michaelkrzyzaniak/squiggles-pipe-organ/README.md

# squiggles-pipe-organ
Pipe organ project for Dr Squiggles
