michaelkrzyzaniak/squiggles-pipe-organ/air_supply/design_files/Junction_Box.pdf

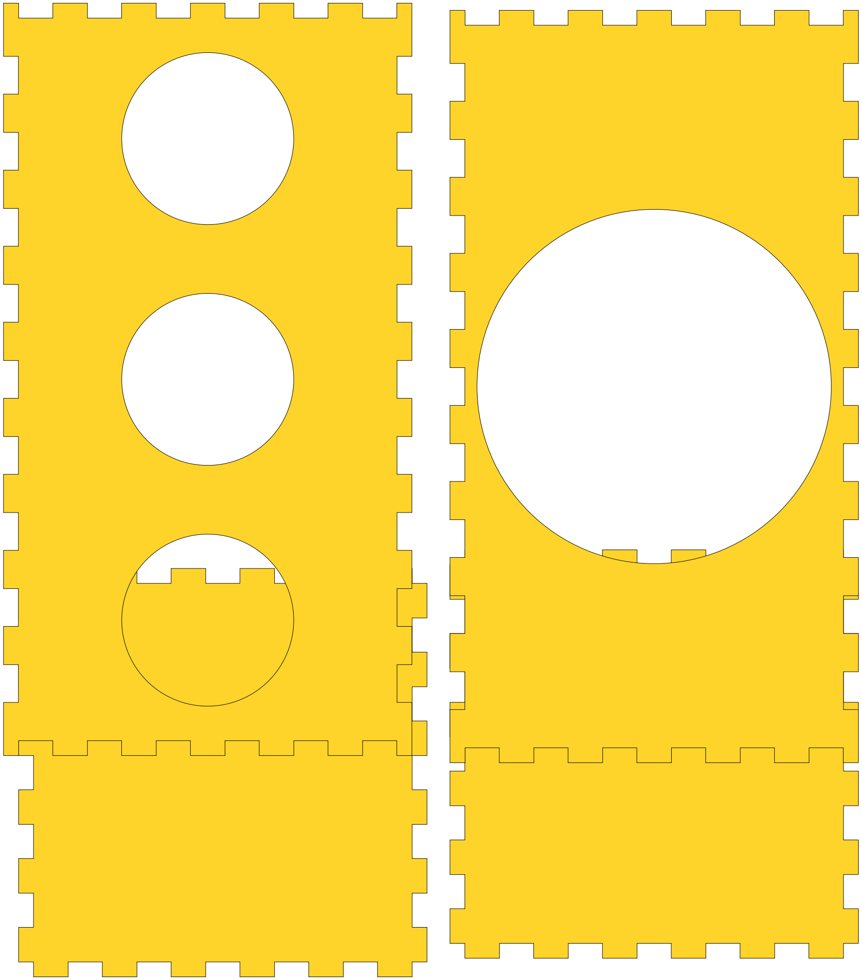
[picture p1: figure]
