michaelkrzyzaniak/squiggles-pipe-organ/air_supply/design_files/Wall.pdf

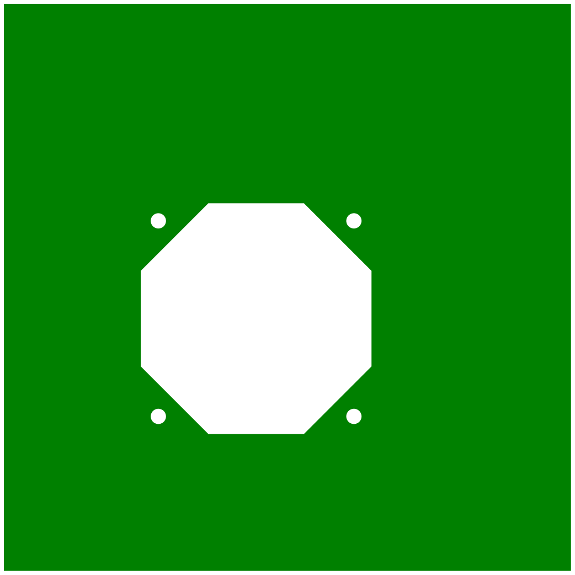
[picture p2: figure]
