michaelkrzyzaniak/squiggles-pipe-organ/wind_chest/design_files/Organ_Pipe_Box_Designs_2.pdf

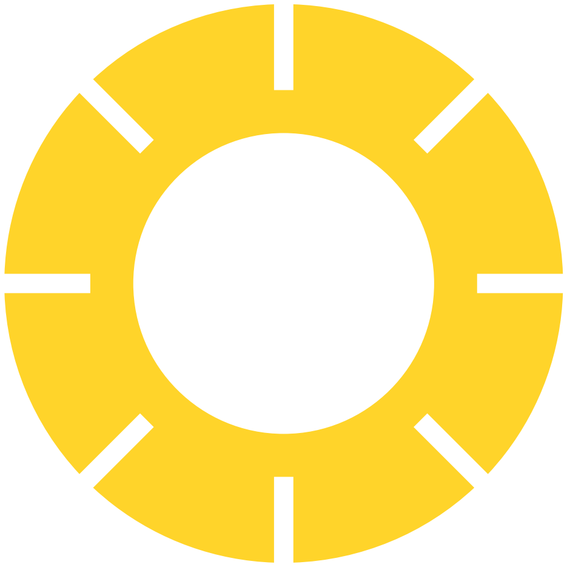
[picture p3: figure]
