michaelkrzyzaniak/squiggles-pipe-organ/air_supply/design_files/Screenshot 2020-10-05 at 7.51.37 AM.png

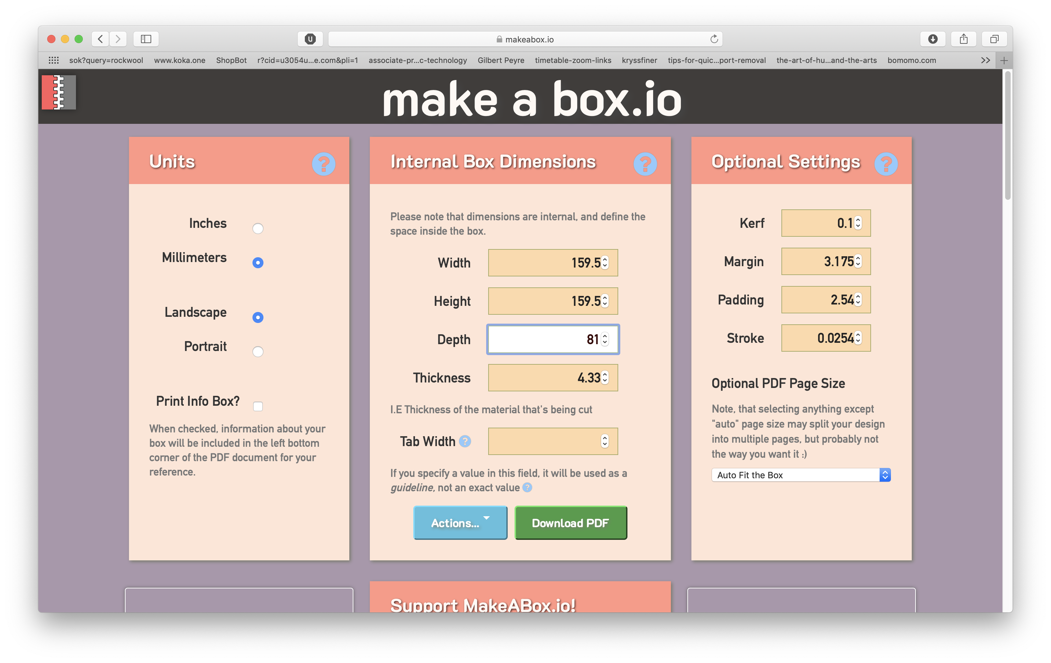
air_supply/design_files/Screenshot 2020-10-05 at 7.51.37 AM.png
