michaelkrzyzaniak/squiggles-pipe-organ/air_supply/Loudenss/Audio/Recordings/01.aif.png

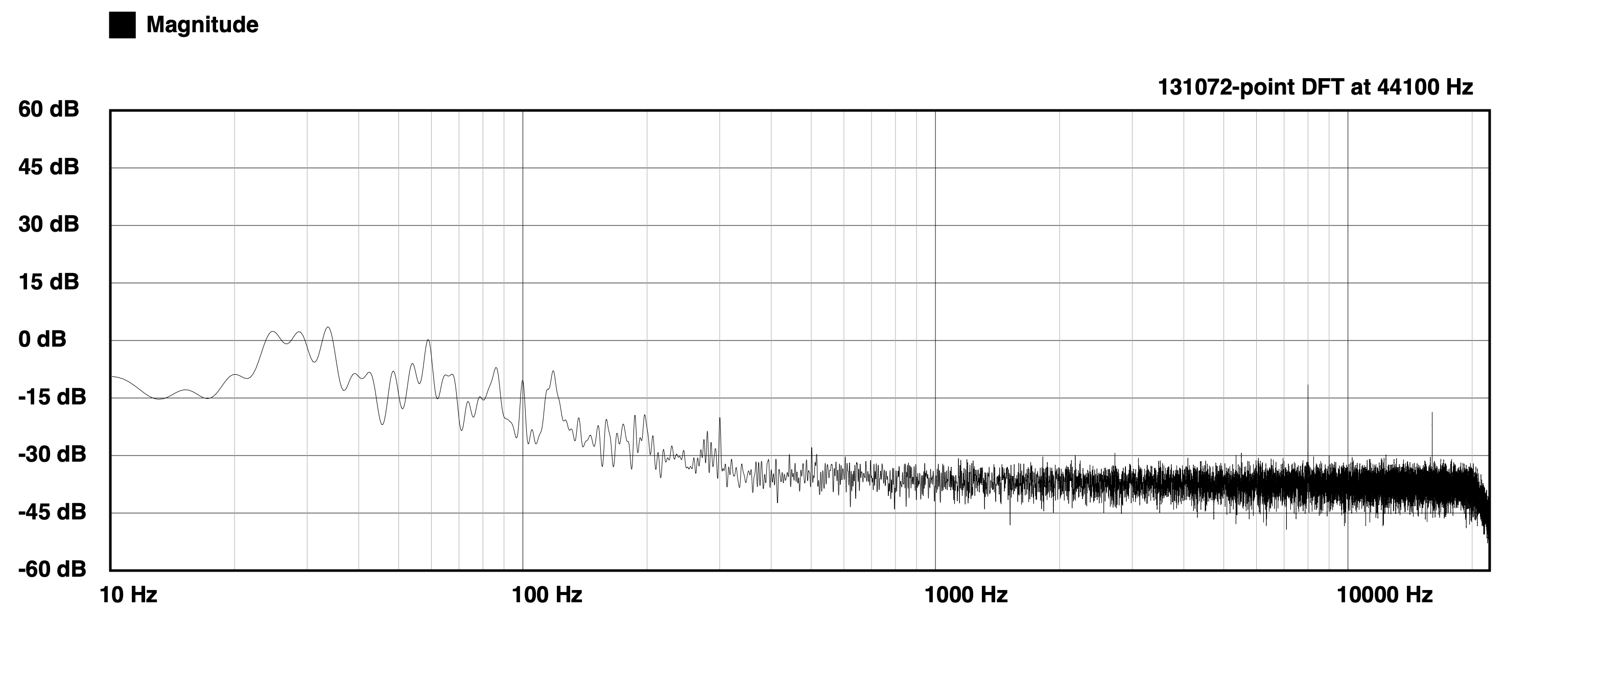
air_supply/Loudenss/Audio/Recordings/01.aif.png
