michaelkrzyzaniak/squiggles-pipe-organ/air_supply/Loudenss/Audio/Recordings/02.aif.png

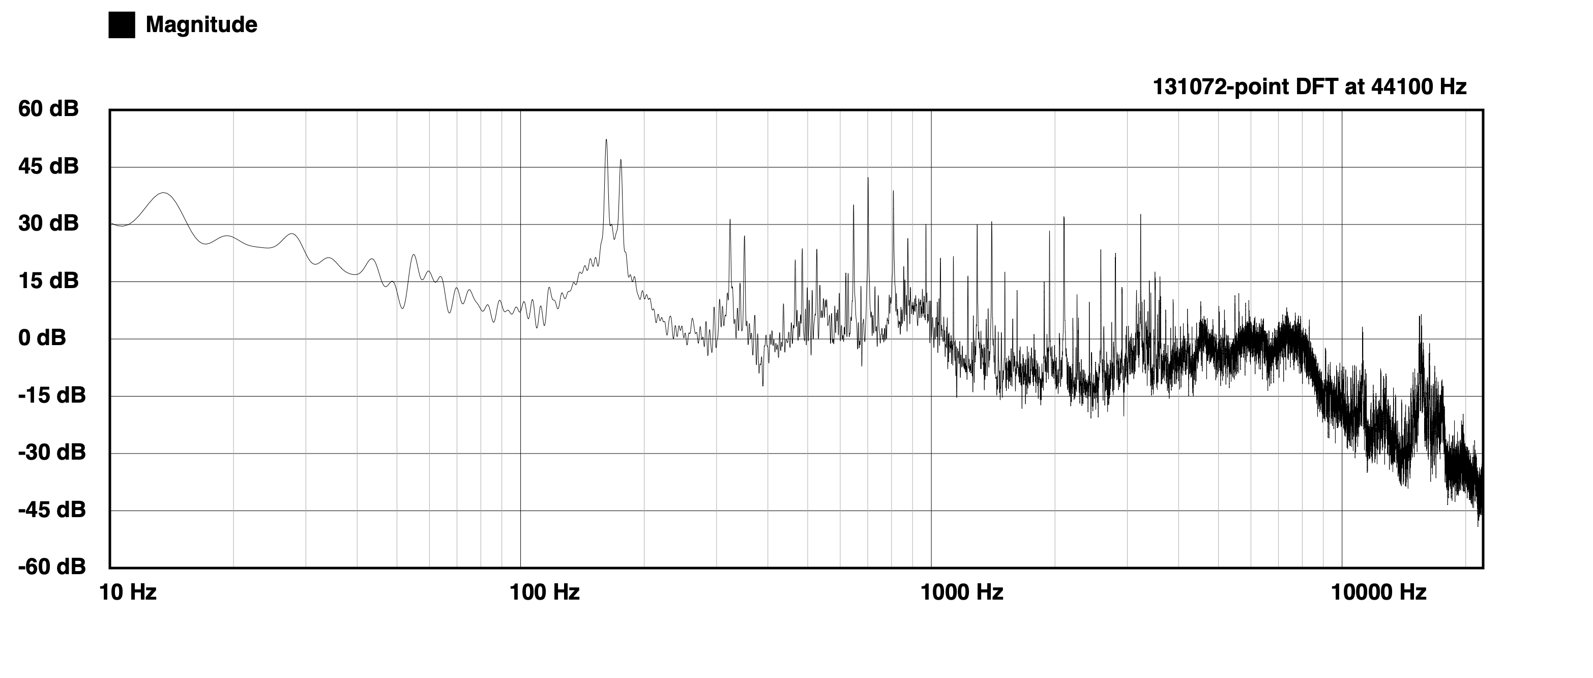
air_supply/Loudenss/Audio/Recordings/02.aif.png
