michaelkrzyzaniak/squiggles-pipe-organ/air_supply/Loudenss/Audio/Recordings/03.aif.png

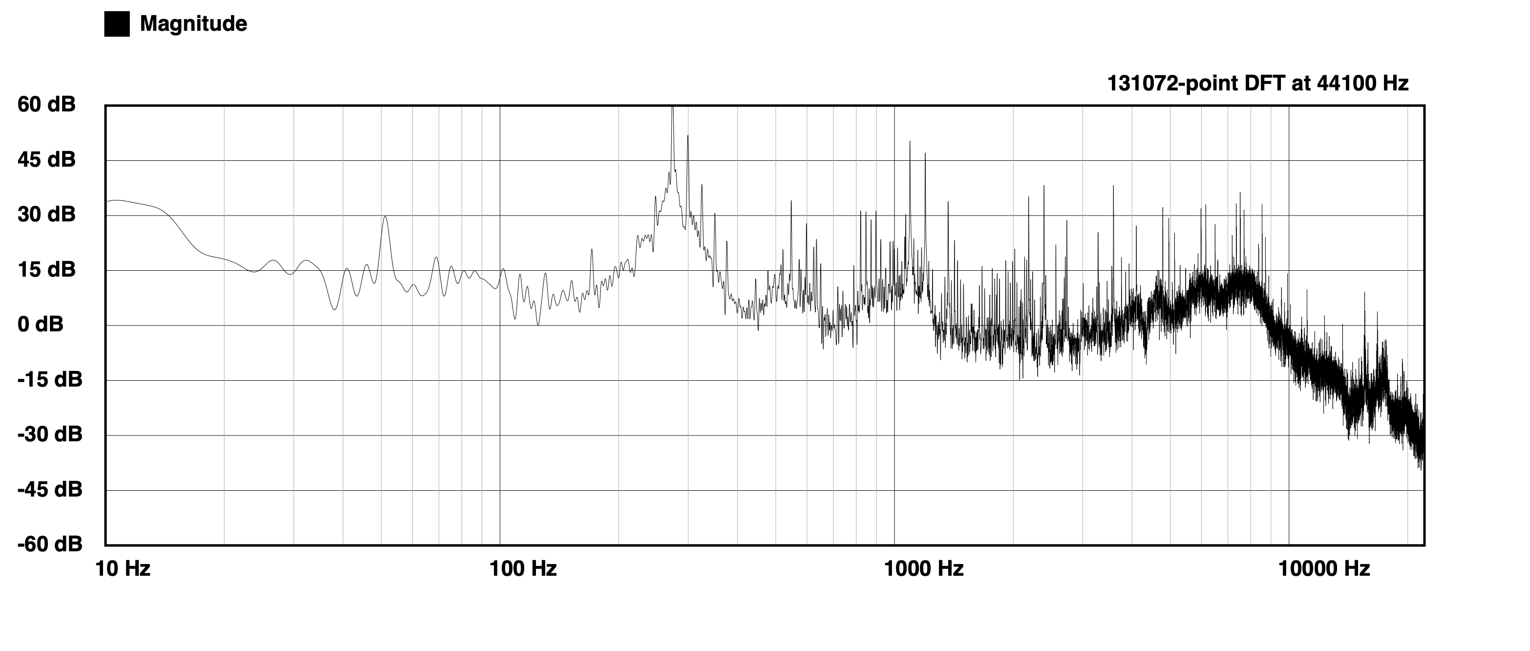
air_supply/Loudenss/Audio/Recordings/03.aif.png
