michaelkrzyzaniak/squiggles-pipe-organ/air_supply/Loudenss/Audio/Recordings/04.aif.png

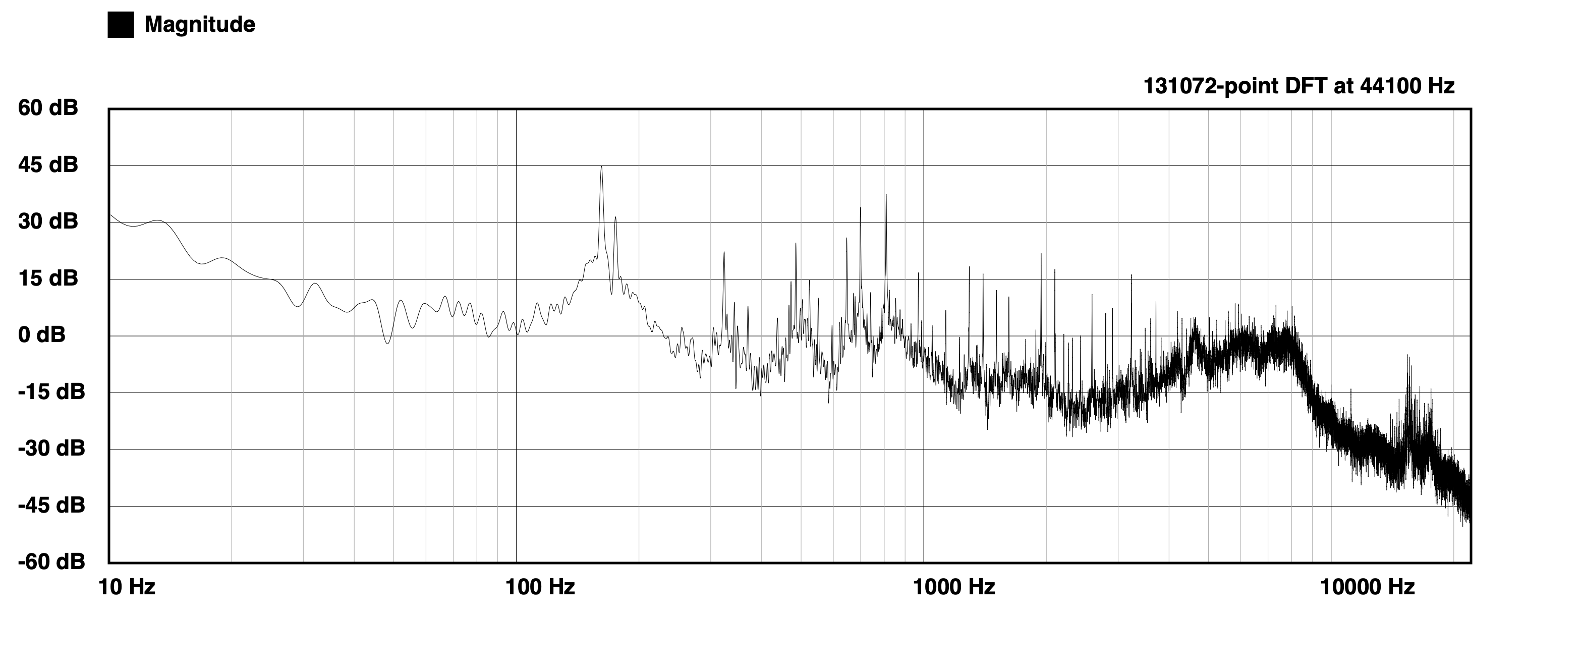
air_supply/Loudenss/Audio/Recordings/04.aif.png
