michaelkrzyzaniak/squiggles-pipe-organ/air_supply/Loudenss/Audio/Recordings/06.aif.png

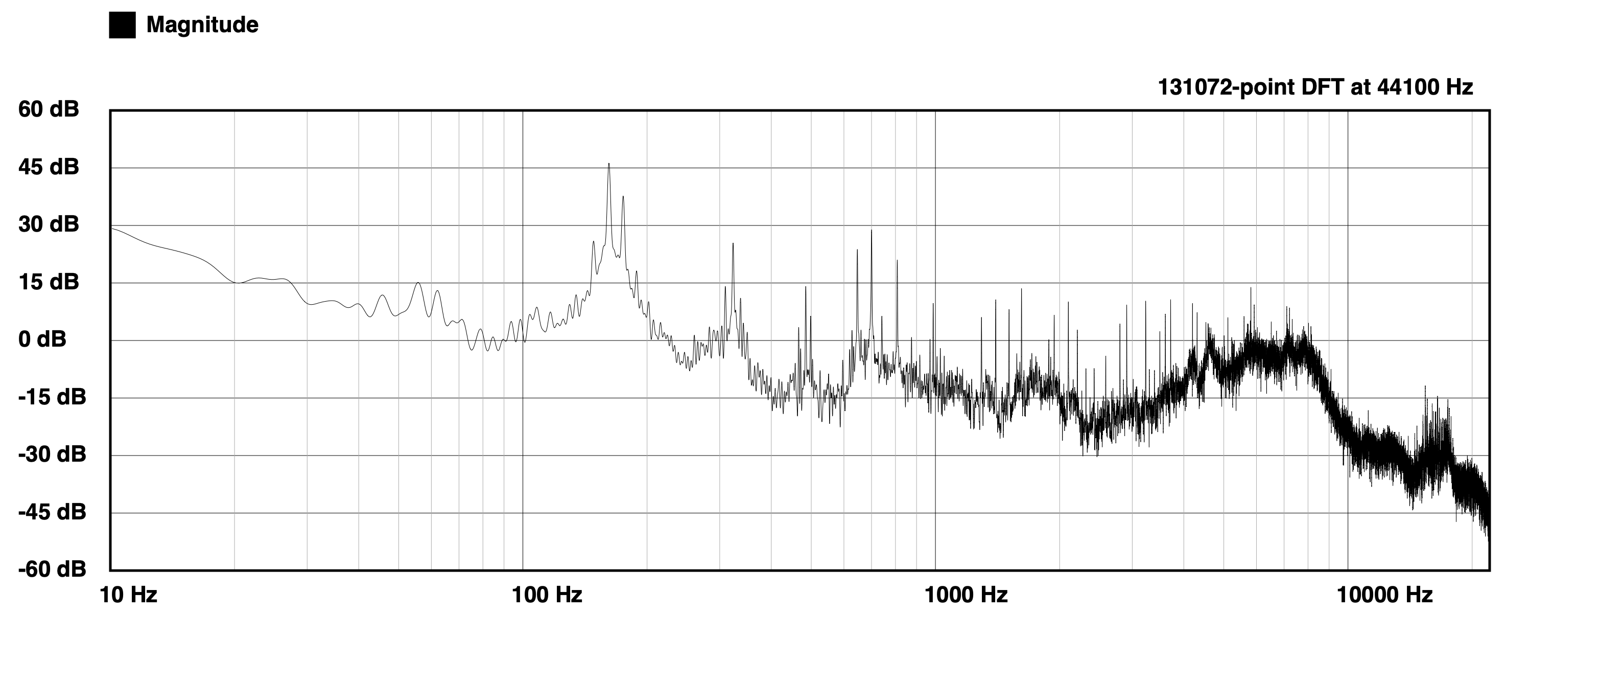
air_supply/Loudenss/Audio/Recordings/06.aif.png
