michaelkrzyzaniak/squiggles-pipe-organ/air_supply/Loudenss/Audio/Recordings/07.aif.png

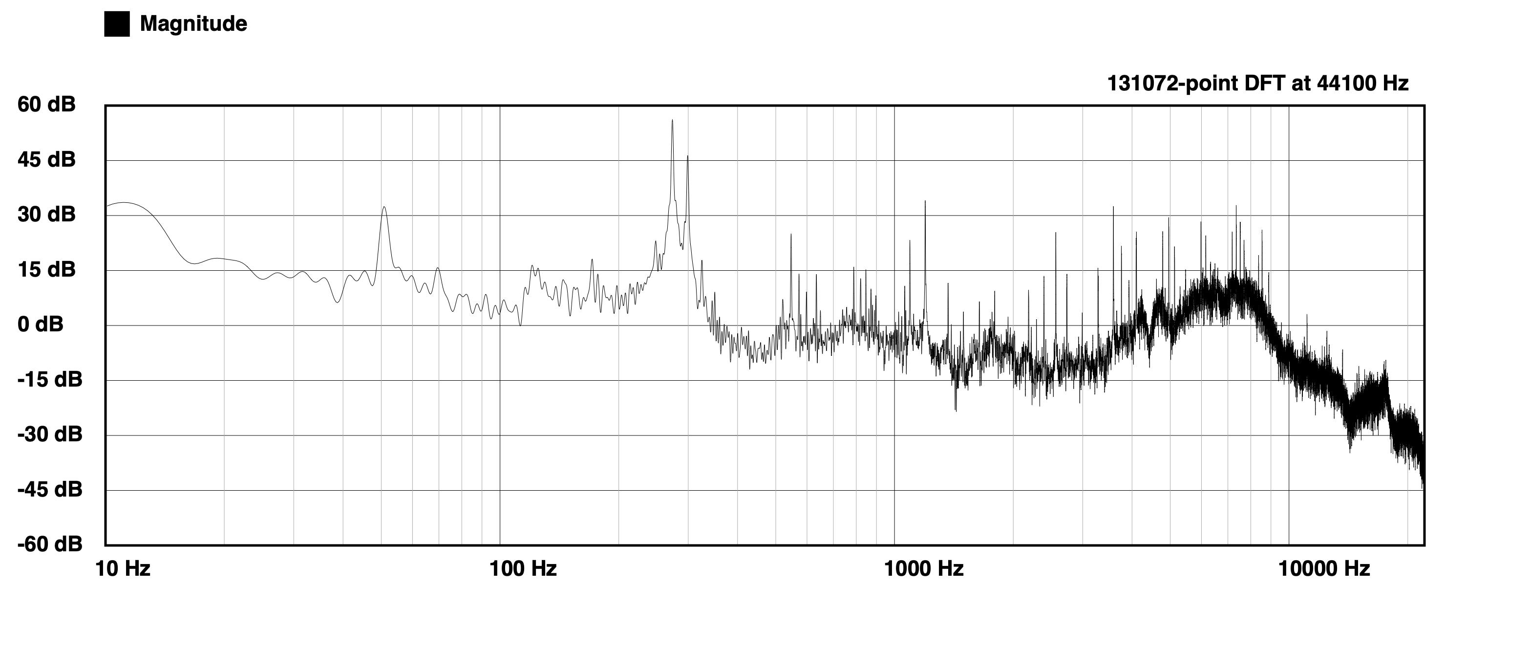
air_supply/Loudenss/Audio/Recordings/07.aif.png
