michaelkrzyzaniak/squiggles-pipe-organ/air_supply/Loudenss/Audio/Recordings/08.aif.png

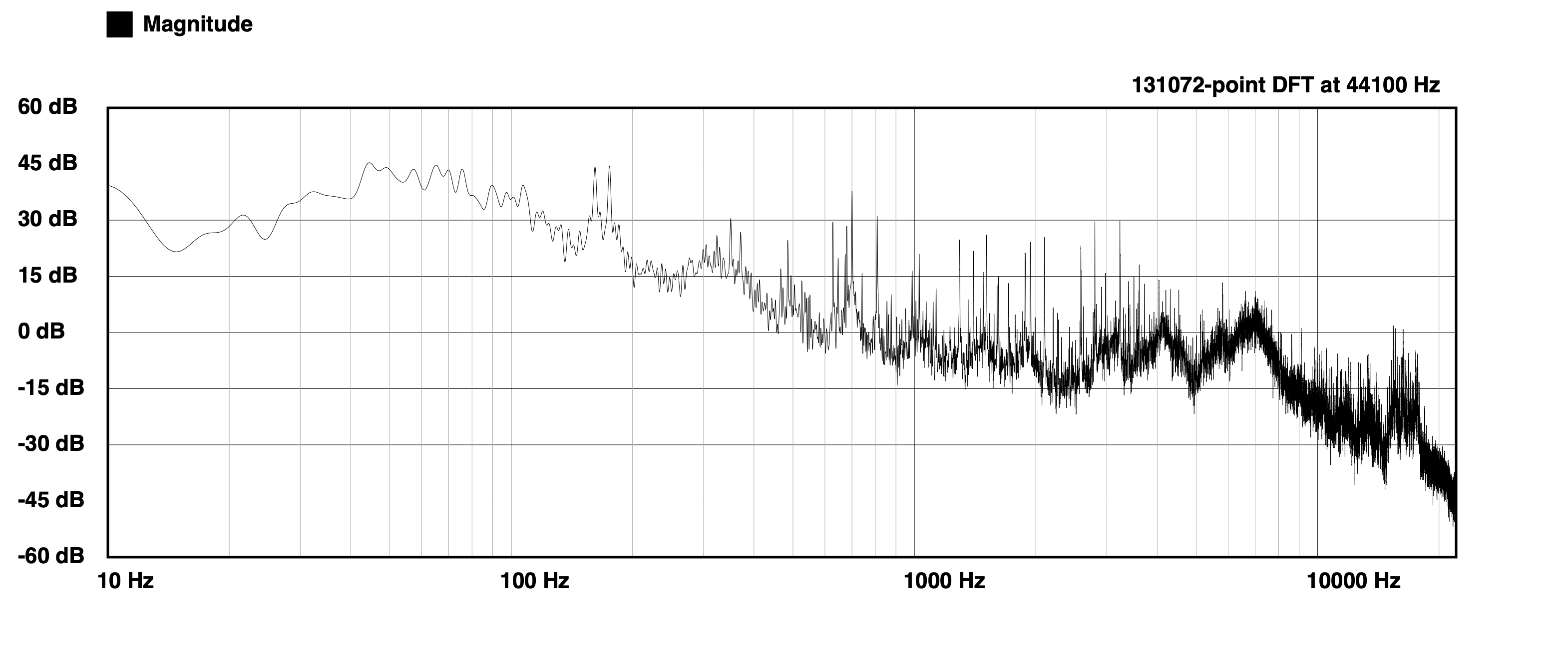
air_supply/Loudenss/Audio/Recordings/08.aif.png
