michaelkrzyzaniak/squiggles-pipe-organ/air_supply/Loudenss/Audio/Recordings/10.aif.png

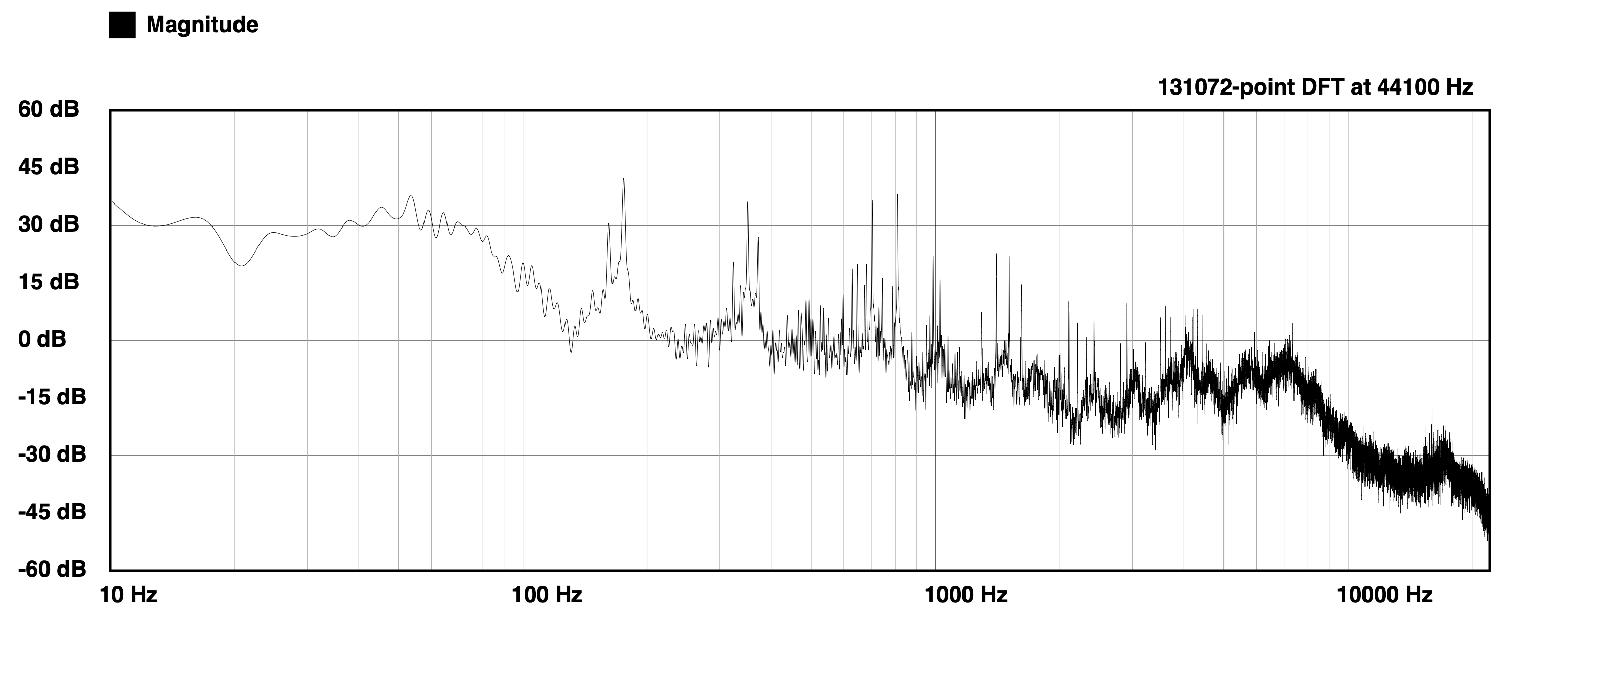
air_supply/Loudenss/Audio/Recordings/10.aif.png
