michaelkrzyzaniak/squiggles-pipe-organ/air_supply/Loudenss/Audio/Recordings/14.aif.png

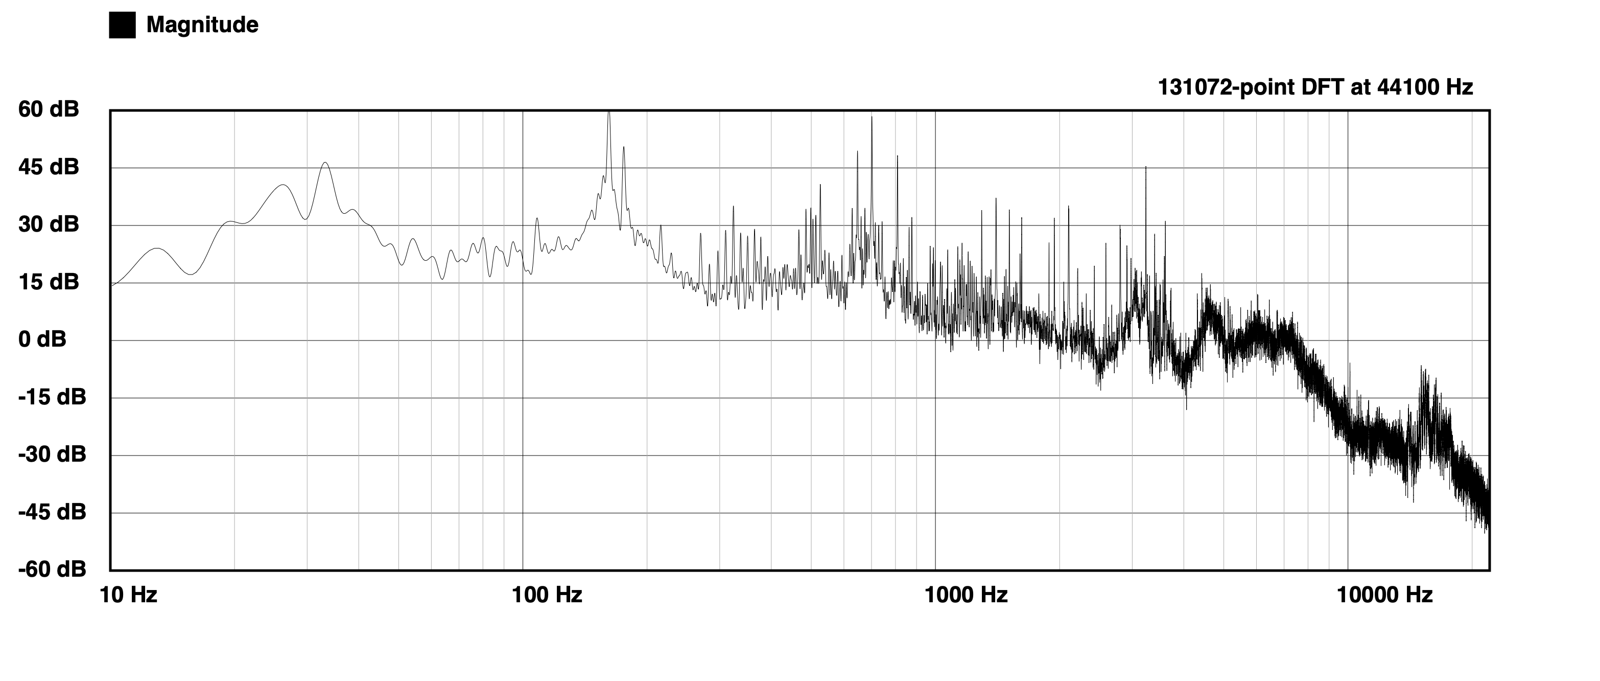
air_supply/Loudenss/Audio/Recordings/14.aif.png
