michaelkrzyzaniak/squiggles-pipe-organ/air_supply/Loudenss/Audio/Recordings/16.aif.png

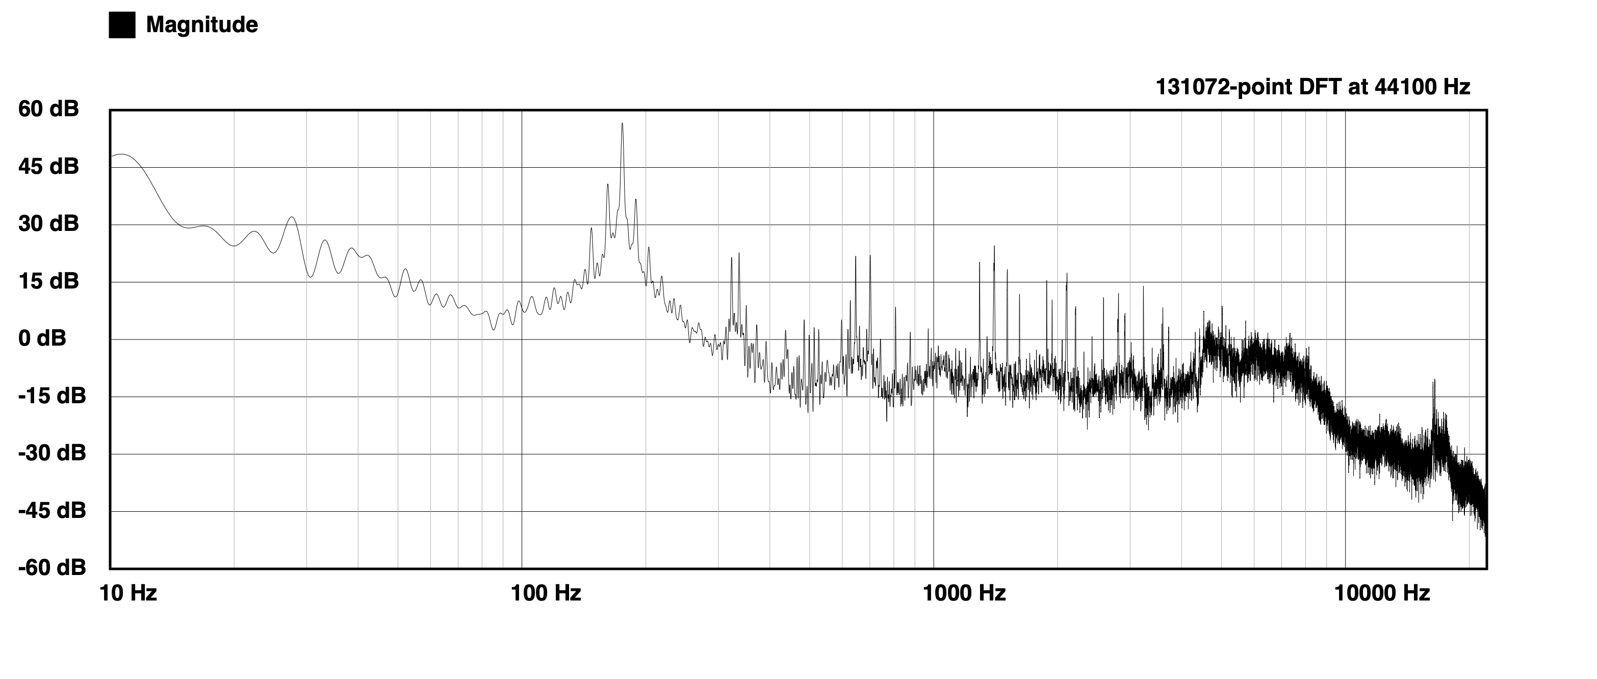
air_supply/Loudenss/Audio/Recordings/16.aif.png
