michaelkrzyzaniak/squiggles-pipe-organ/air_supply/Loudenss/Audio/Recordings/20.aif.png

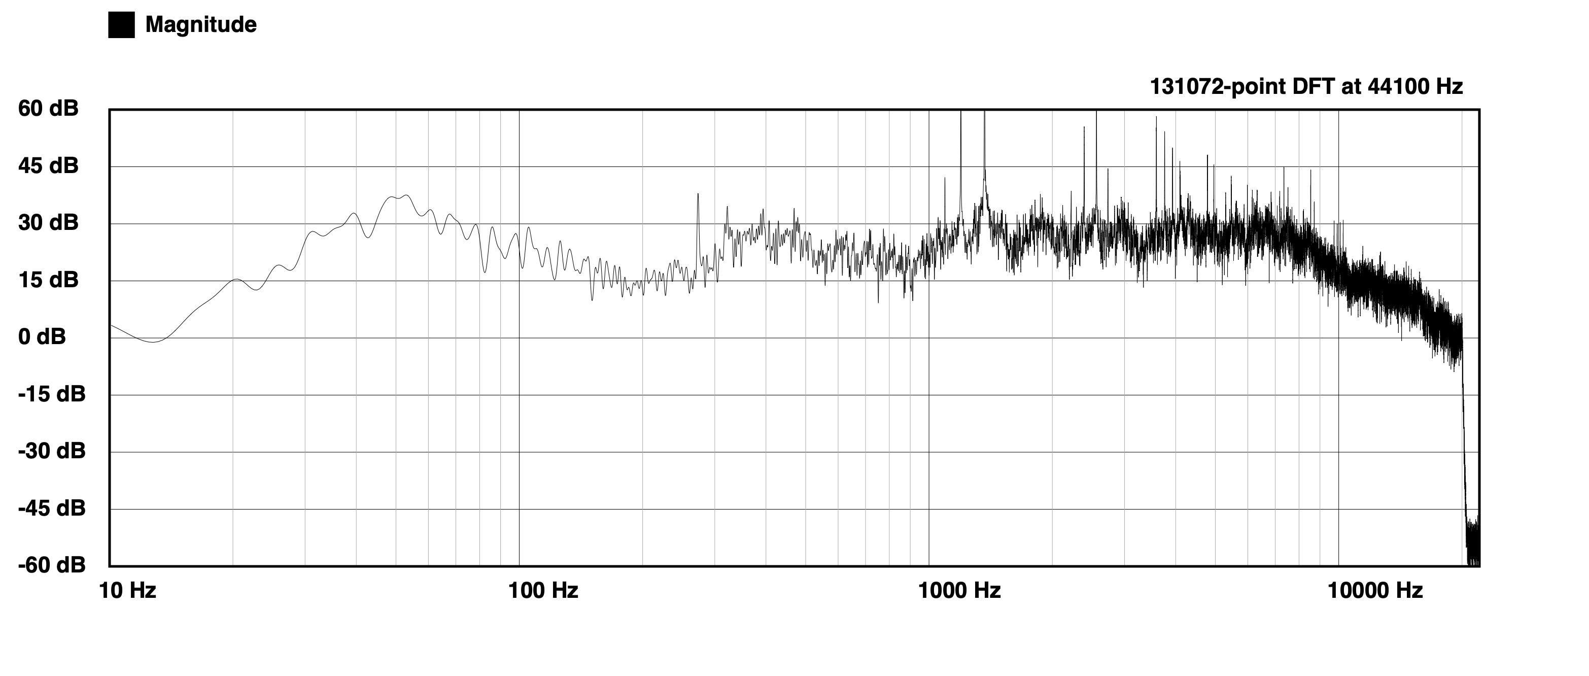
air_supply/Loudenss/Audio/Recordings/20.aif.png
