michaelkrzyzaniak/squiggles-pipe-organ/air_supply/Loudenss/Audio/Recordings/21.aif.png

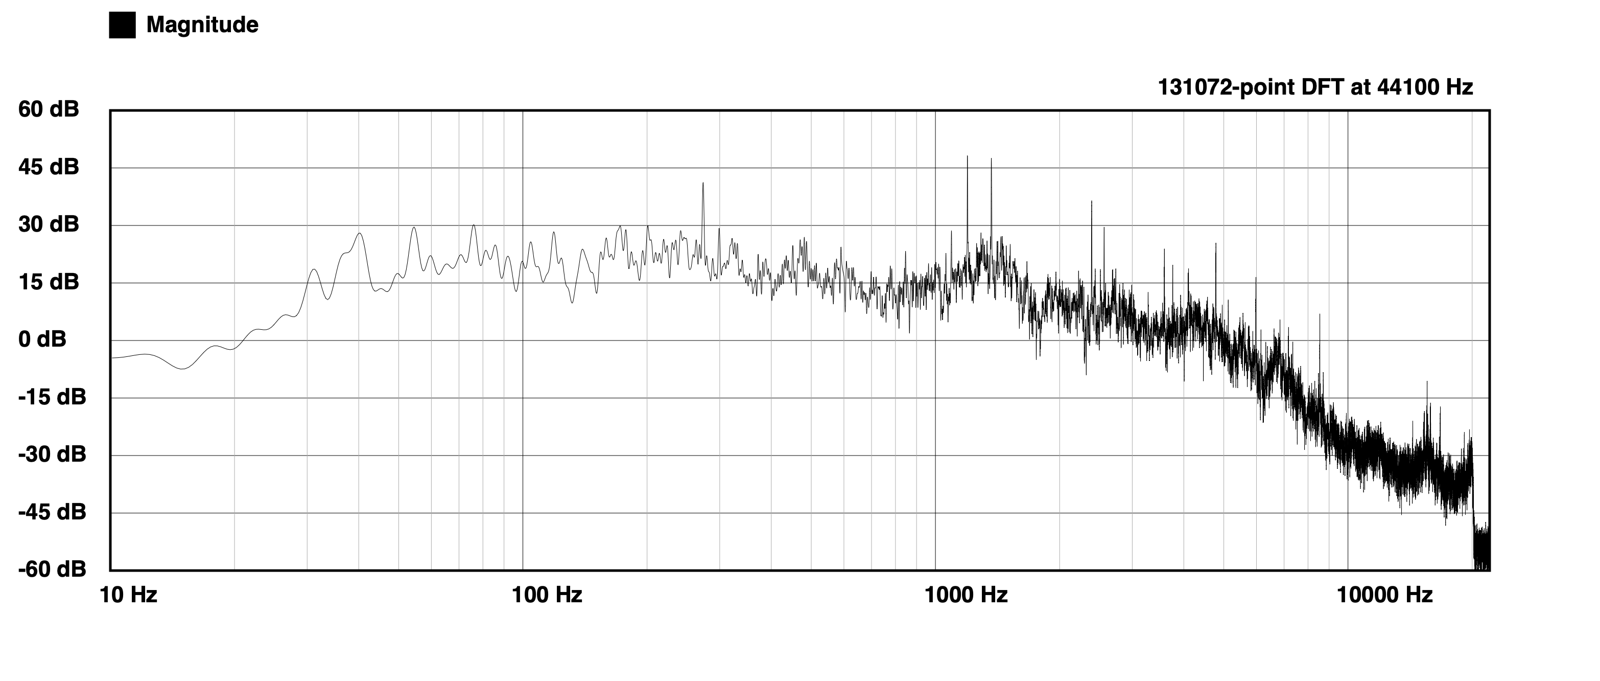
air_supply/Loudenss/Audio/Recordings/21.aif.png
