michaelkrzyzaniak/squiggles-pipe-organ/pipe_designs/Data/MIDI_52.jpg

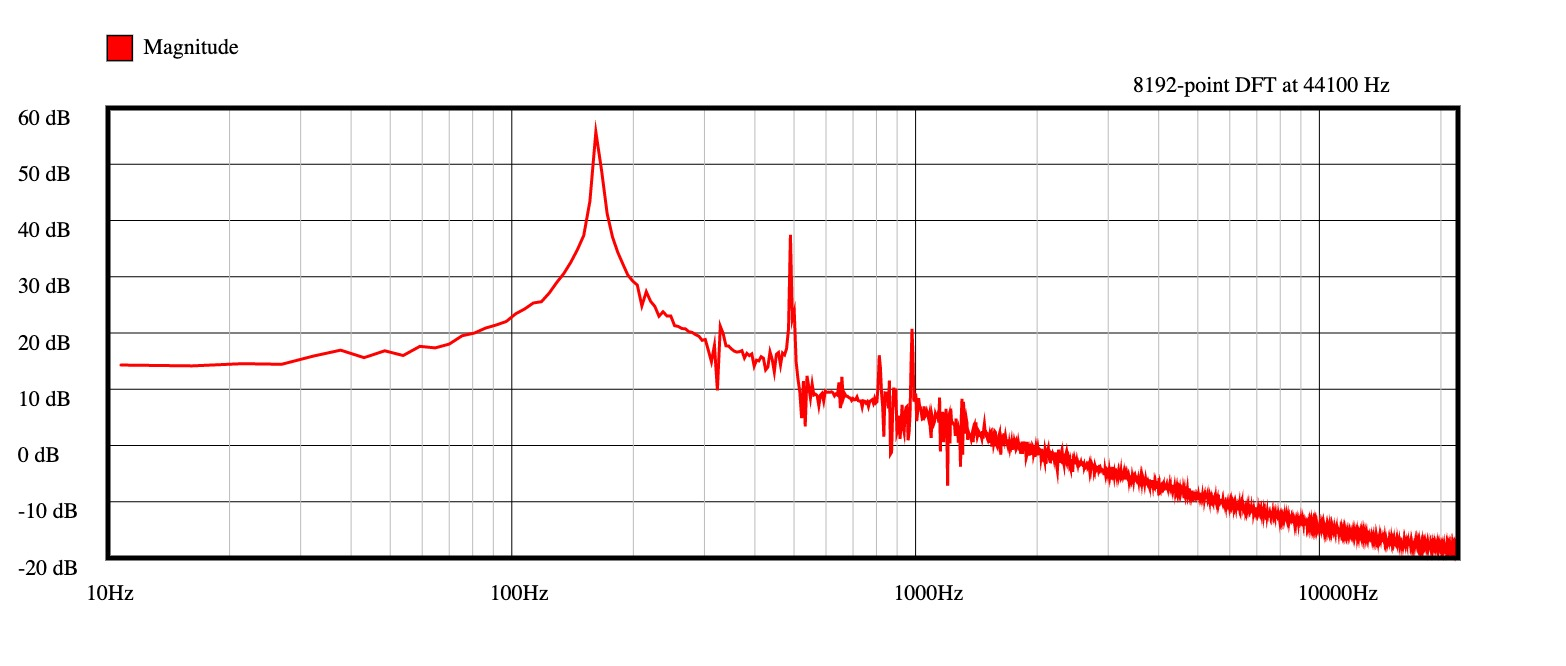
pipe_designs/Data/MIDI_52.jpg
