michaelkrzyzaniak/squiggles-pipe-organ/pipe_designs/Data/MIDI_75.jpg

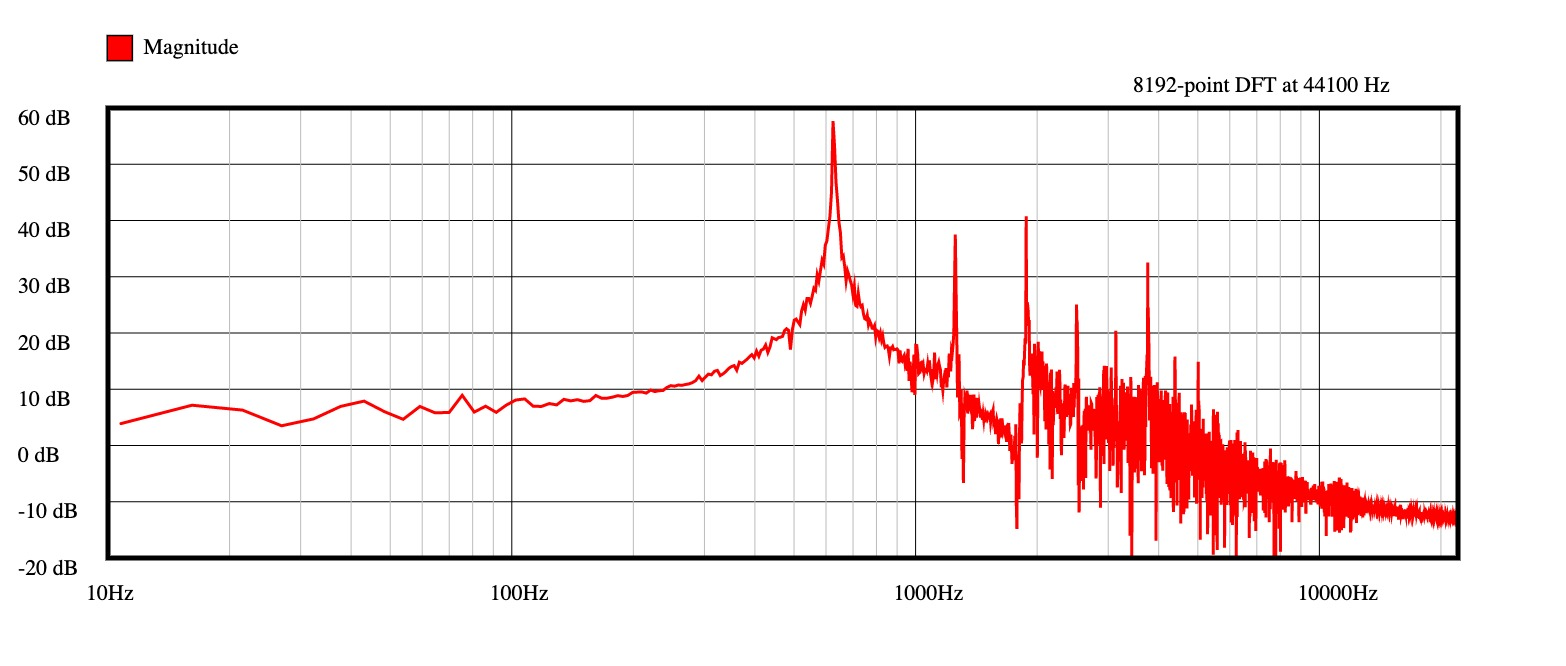
pipe_designs/Data/MIDI_75.jpg
