michaelkrzyzaniak/squiggles-pipe-organ/pipe_designs/il_1588xN.2406703341_5kel.jpg

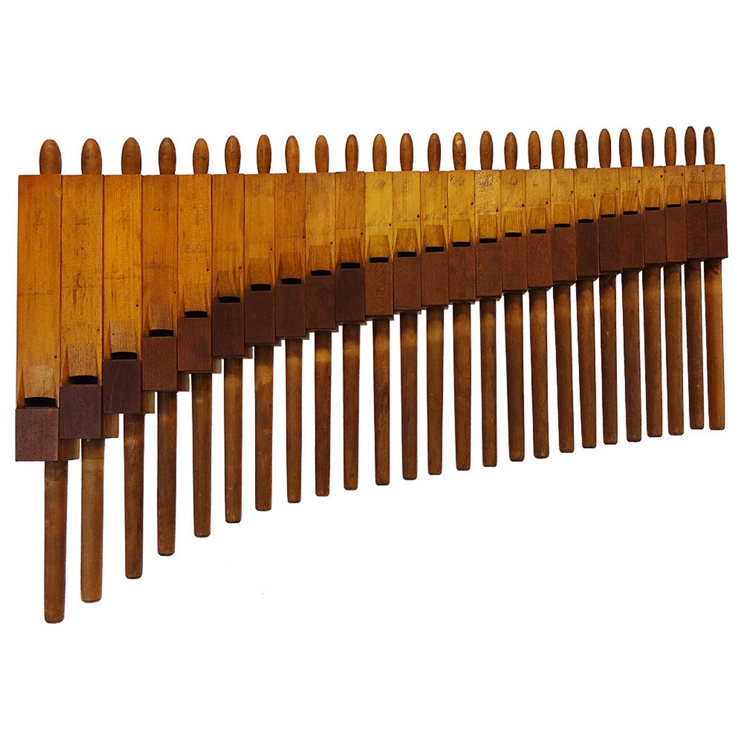
pipe_designs/il_1588xN.2406703341_5kel.jpg
