michaelkrzyzaniak/squiggles-pipe-organ/pipe_designs/Pipe_Settings.jpg

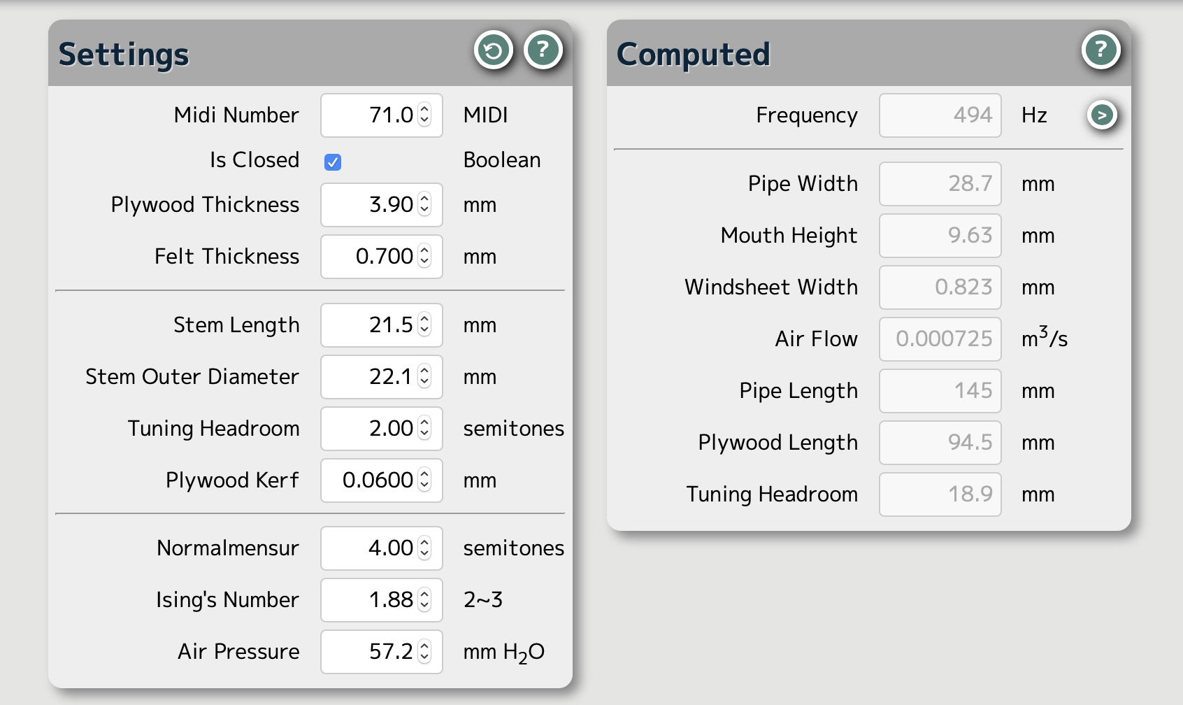
pipe_designs/Pipe_Settings.jpg
