michaelkrzyzaniak/squiggles-pipe-organ/pipe_designs/3d_Print/061_closed_3.9mm.stl

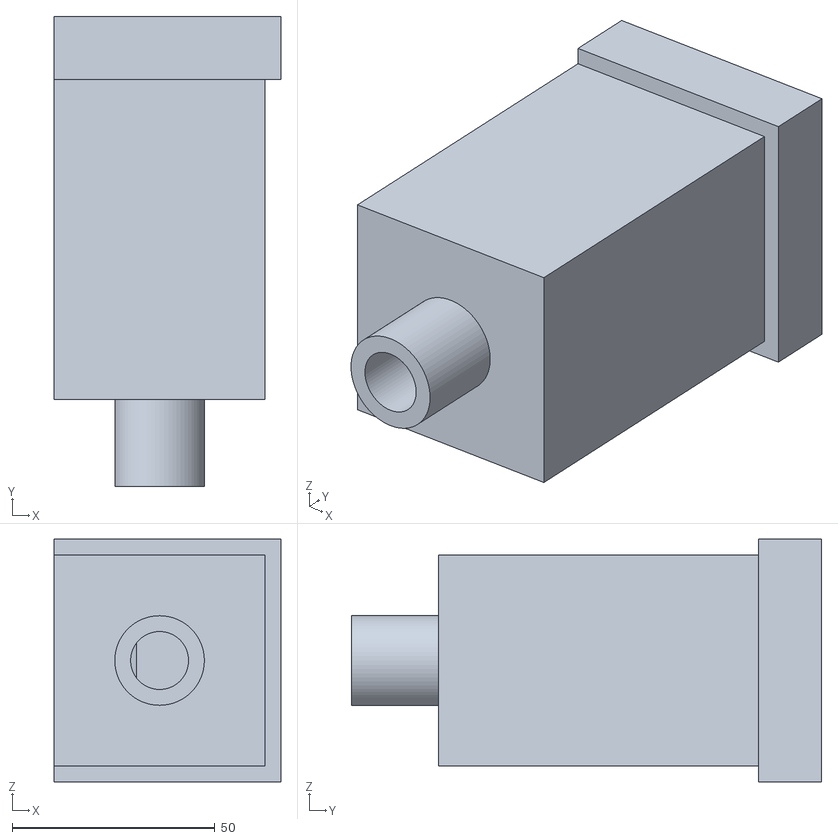
[picture p21: CAD file, 2021-03-25]
pipe_designs/3d_Print/061_closed_3.9mm.stl
56.0 x 116.0 x 59.9
