michaelkrzyzaniak/squiggles-pipe-organ/pipe_designs/3d_Print/065_closed_3.9mm.stl

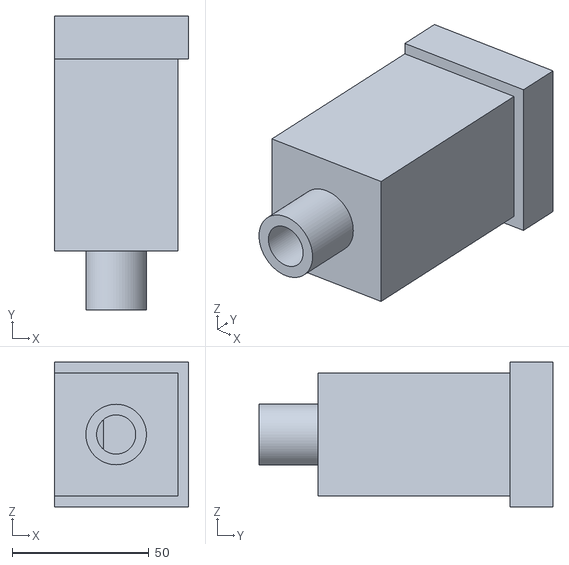
[picture p22: CAD file, 2021-03-25]
pipe_designs/3d_Print/065_closed_3.9mm.stl
48.9 x 107.3 x 52.8
