michaelkrzyzaniak/squiggles-pipe-organ/pipe_designs/3d_Print/064_closed_3.9mm.stl

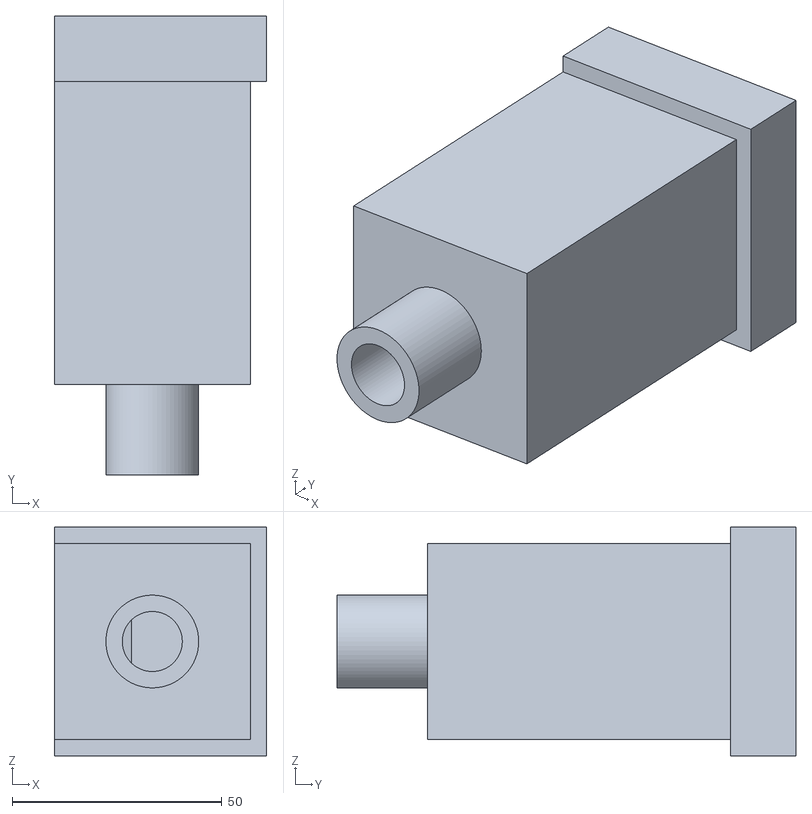
[picture p23: CAD file, 2021-03-25]
pipe_designs/3d_Print/064_closed_3.9mm.stl
50.6 x 109.3 x 54.5
