michaelkrzyzaniak/squiggles-pipe-organ/pipe_designs/3d_Print/057_closed_3.9mm.stl

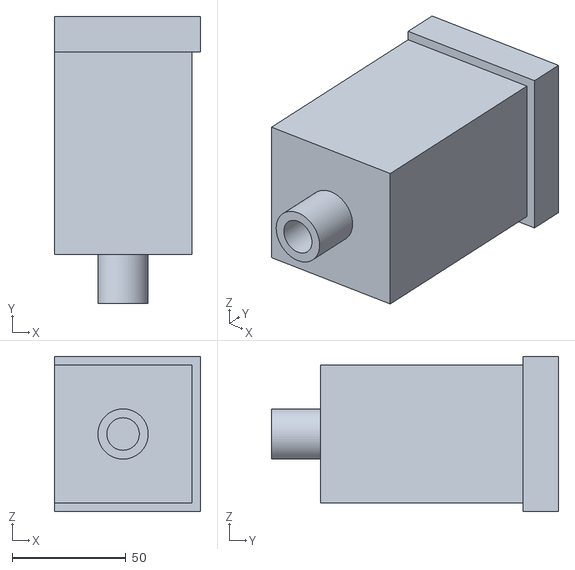
[picture p24: CAD file, 2021-03-25]
pipe_designs/3d_Print/057_closed_3.9mm.stl
64.3 x 126.1 x 68.2
