michaelkrzyzaniak/squiggles-pipe-organ/pipe_designs/3d_Print/073_closed_3.9mm.stl

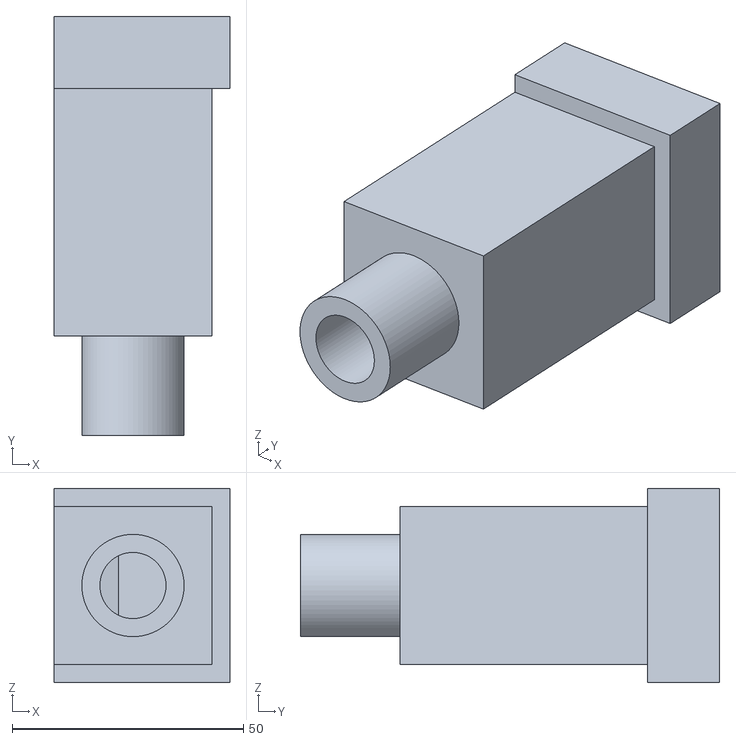
[picture p25: CAD file, 2021-03-25]
pipe_designs/3d_Print/073_closed_3.9mm.stl
38.0 x 90.6 x 41.9
