michaelkrzyzaniak/squiggles-pipe-organ/pipe_designs/3d_Print/069_closed_3.9mm.stl

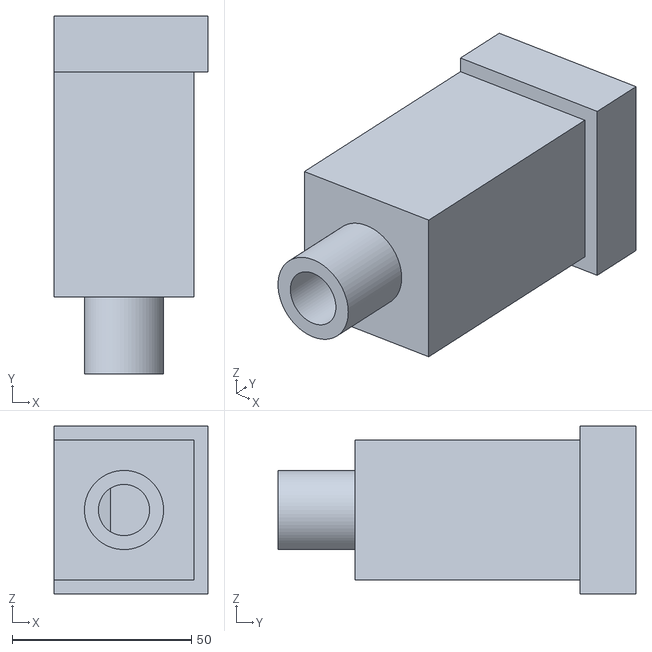
[picture p26: CAD file, 2021-03-25]
pipe_designs/3d_Print/069_closed_3.9mm.stl
43.0 x 99.9 x 46.9
