michaelkrzyzaniak/squiggles-pipe-organ/pipe_designs/3d_Print/072_closed_3.9mm.stl

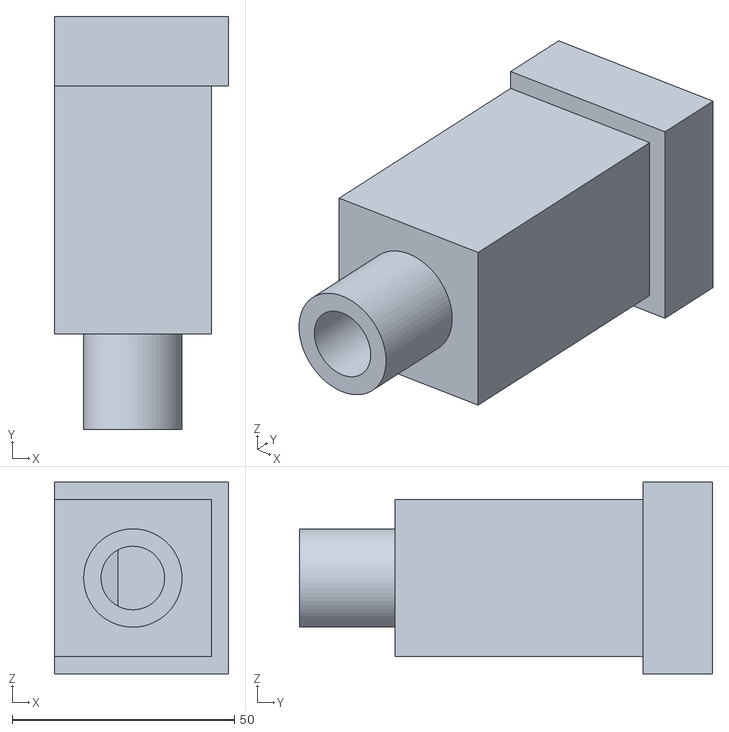
[picture p27: CAD file, 2021-03-25]
pipe_designs/3d_Print/072_closed_3.9mm.stl
39.2 x 92.8 x 43.1
