michaelkrzyzaniak/squiggles-pipe-organ/pipe_designs/3d_Print/071_closed_3.9mm.stl

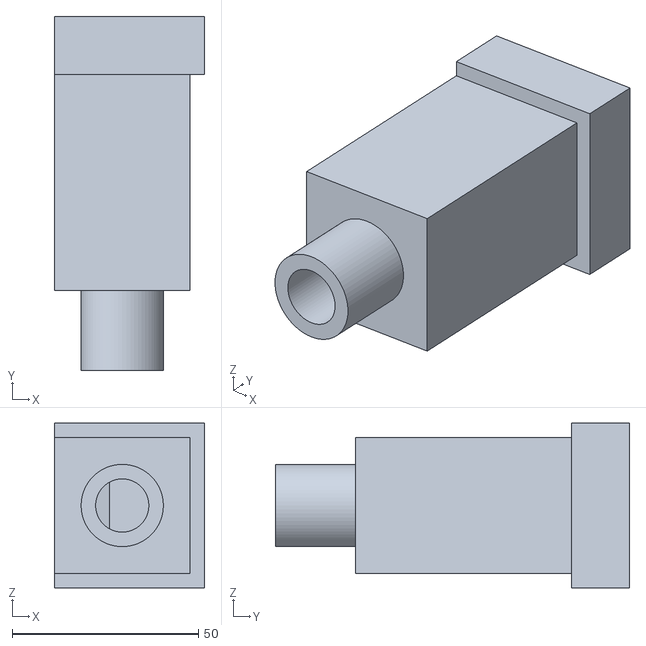
[picture p28: CAD file, 2021-03-25]
pipe_designs/3d_Print/071_closed_3.9mm.stl
40.4 x 95.1 x 44.3
