michaelkrzyzaniak/squiggles-pipe-organ/pipe_designs/3d_Print/055_closed_3.9mm.stl

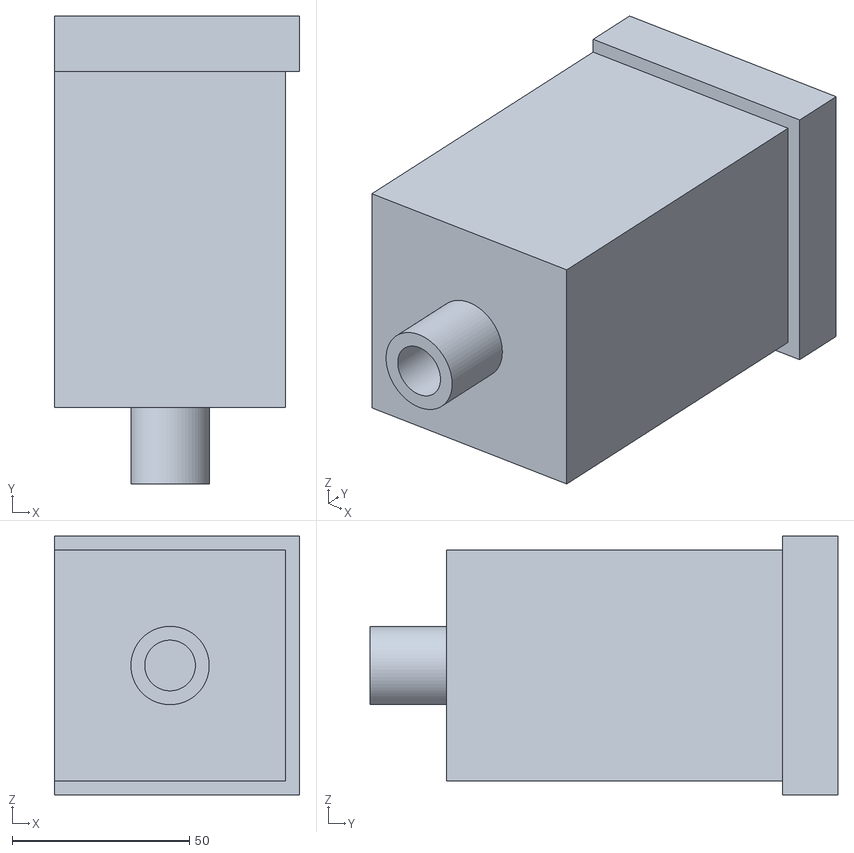
[picture p29: CAD file, 2021-03-25]
pipe_designs/3d_Print/055_closed_3.9mm.stl
69.1 x 131.9 x 73.0
