michaelkrzyzaniak/squiggles-pipe-organ/pipe_designs/3d_Print/059_closed_3.9mm.stl

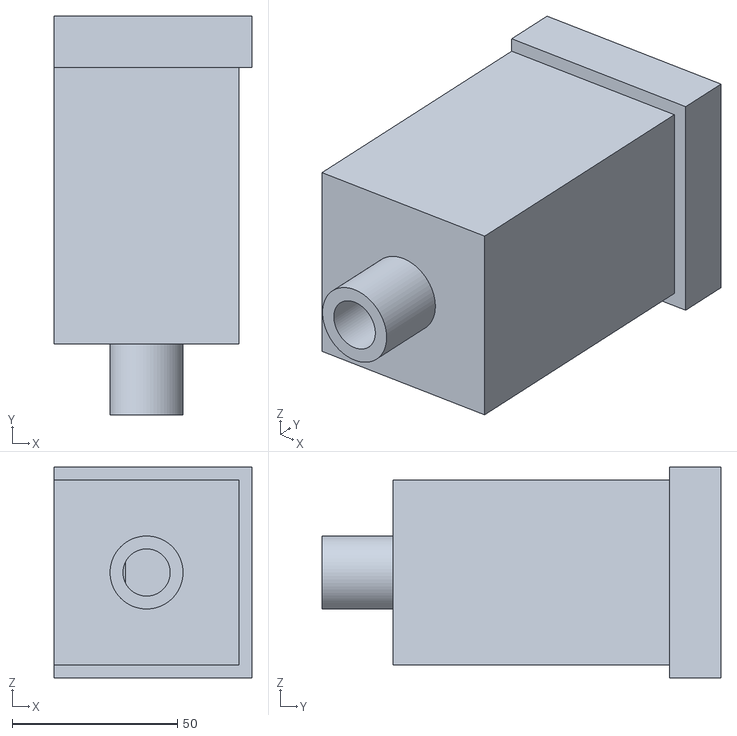
[picture p30: CAD file, 2021-03-25]
pipe_designs/3d_Print/059_closed_3.9mm.stl
60.0 x 120.8 x 63.9
