michaelkrzyzaniak/squiggles-pipe-organ/pipe_designs/3d_Print/052_closed_3.9mm.stl

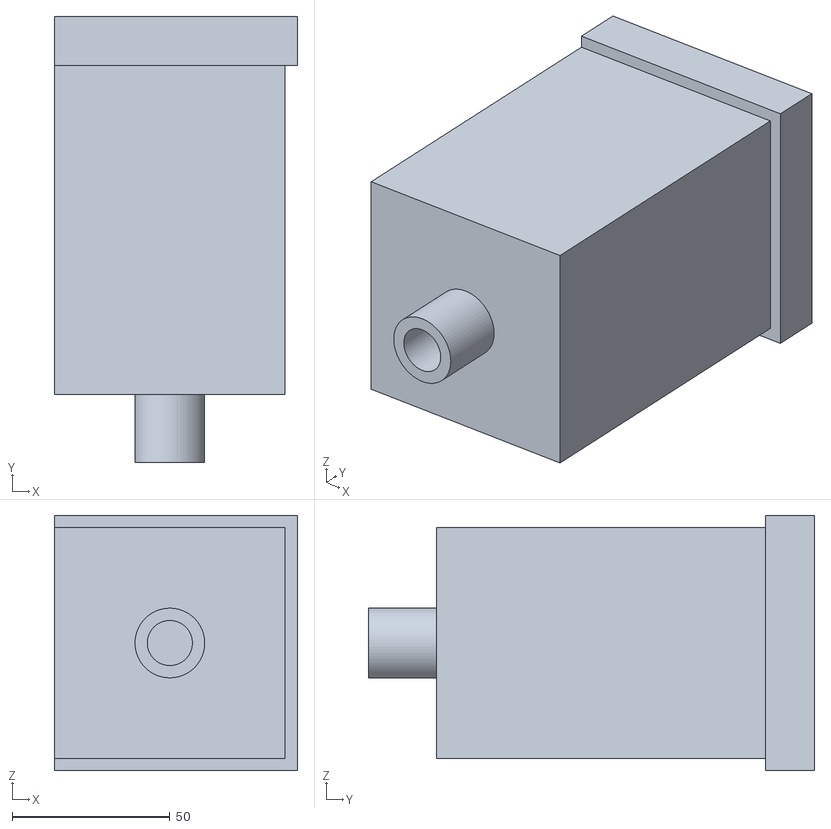
[picture p31: CAD file, 2021-03-25]
pipe_designs/3d_Print/052_closed_3.9mm.stl
77.1 x 141.4 x 81.0
