michaelkrzyzaniak/squiggles-pipe-organ/pipe_designs/3d_Print/054_closed_3.9mm.stl

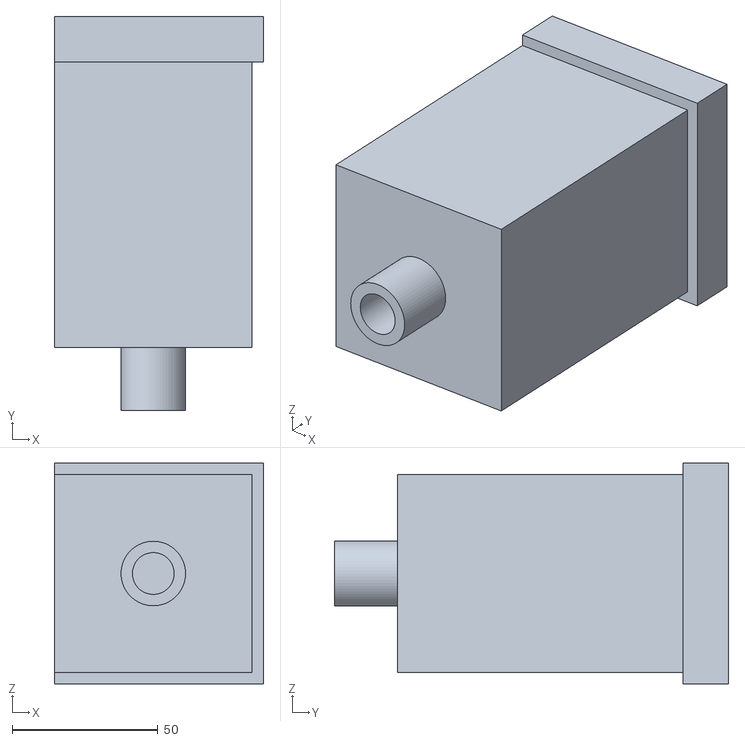
[picture p32: CAD file, 2021-03-25]
pipe_designs/3d_Print/054_closed_3.9mm.stl
71.7 x 134.9 x 75.6
