michaelkrzyzaniak/squiggles-pipe-organ/pipe_designs/3d_Print/056_closed_3.9mm.stl

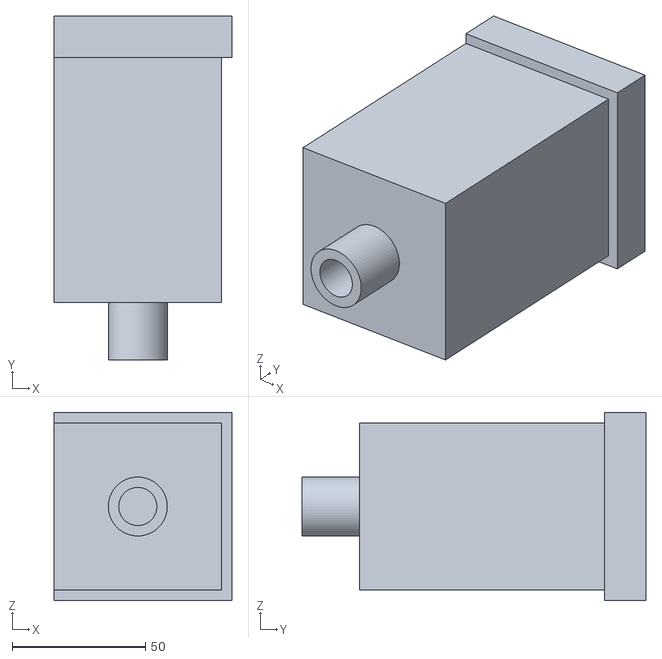
[picture p33: CAD file, 2021-03-25]
pipe_designs/3d_Print/056_closed_3.9mm.stl
66.7 x 129.0 x 70.6
