michaelkrzyzaniak/squiggles-pipe-organ/pipe_designs/3d_Print/063_closed_3.9mm.stl

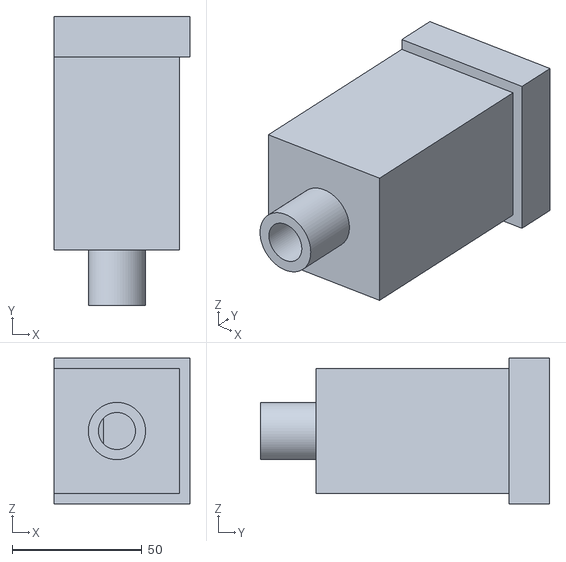
[picture p34: CAD file, 2021-03-25]
pipe_designs/3d_Print/063_closed_3.9mm.stl
52.3 x 111.5 x 56.2
