michaelkrzyzaniak/squiggles-pipe-organ/pipe_designs/3d_Print/066_closed_3.9mm.stl

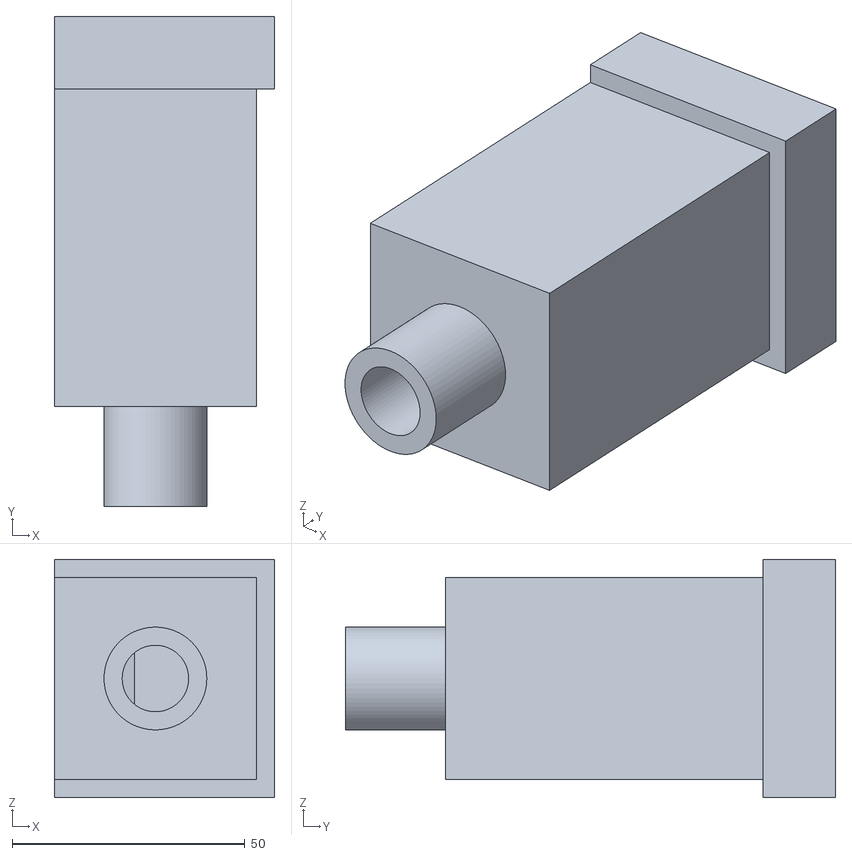
[picture p35: CAD file, 2021-03-25]
pipe_designs/3d_Print/066_closed_3.9mm.stl
47.3 x 105.3 x 51.2
