michaelkrzyzaniak/squiggles-pipe-organ/pipe_designs/3d_Print/058_closed_3.9mm.stl

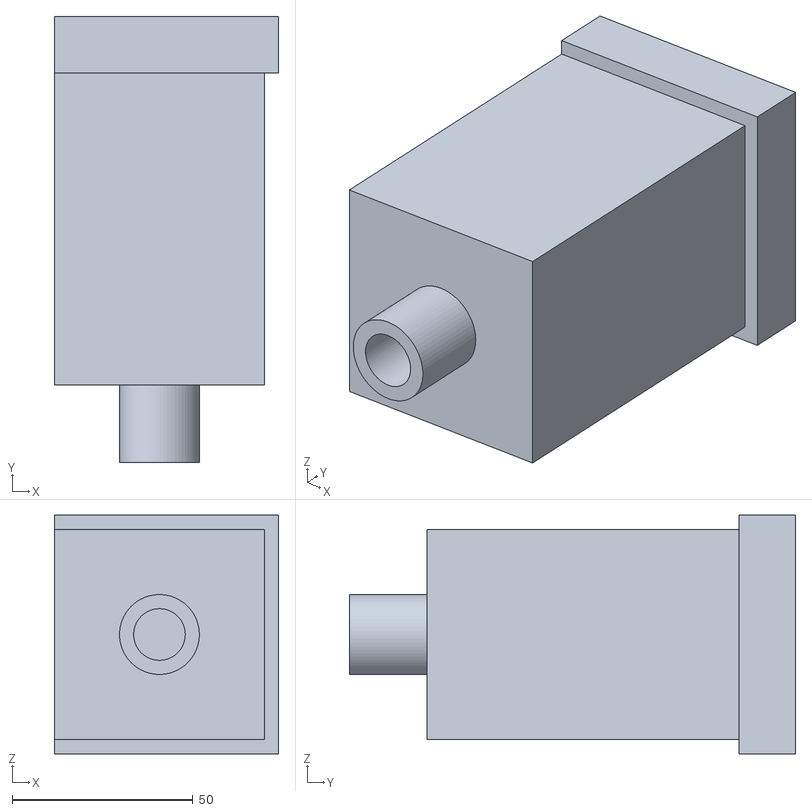
[picture p36: CAD file, 2021-03-25]
pipe_designs/3d_Print/058_closed_3.9mm.stl
62.1 x 123.4 x 66.0
