michaelkrzyzaniak/squiggles-pipe-organ/pipe_designs/3d_Print/060_closed_3.9mm.stl

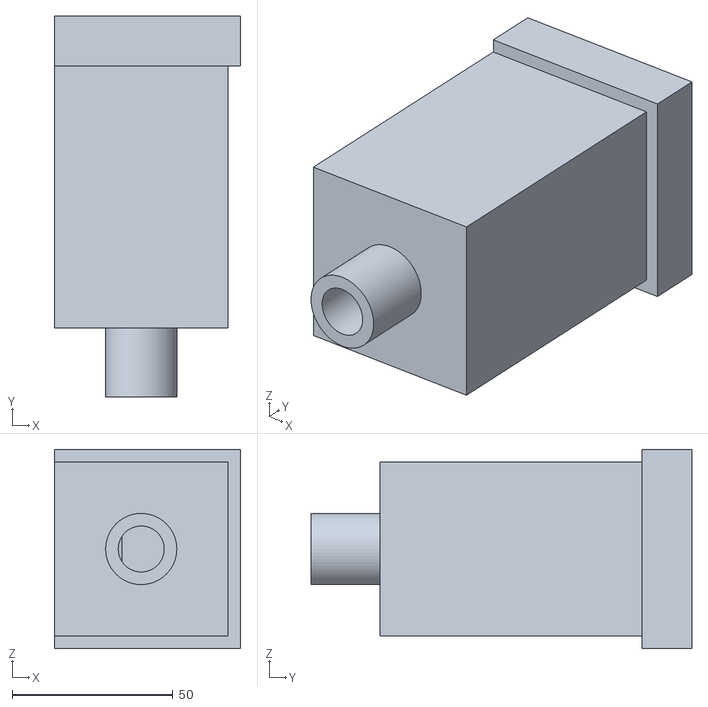
[picture p37: CAD file, 2021-03-25]
pipe_designs/3d_Print/060_closed_3.9mm.stl
57.9 x 118.4 x 61.8
