michaelkrzyzaniak/squiggles-pipe-organ/pipe_designs/3d_Print/074_closed_3.9mm.stl

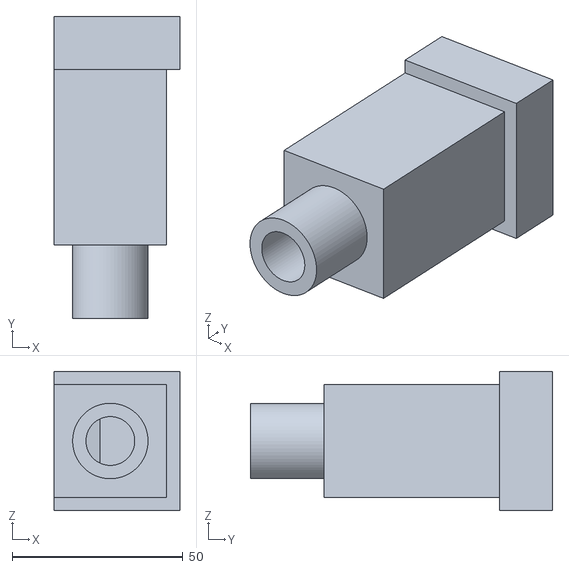
[picture p38: CAD file, 2021-03-25]
pipe_designs/3d_Print/074_closed_3.9mm.stl
36.9 x 88.5 x 40.8
