michaelkrzyzaniak/squiggles-pipe-organ/pipe_designs/3d_Print/053_closed_3.9mm.stl

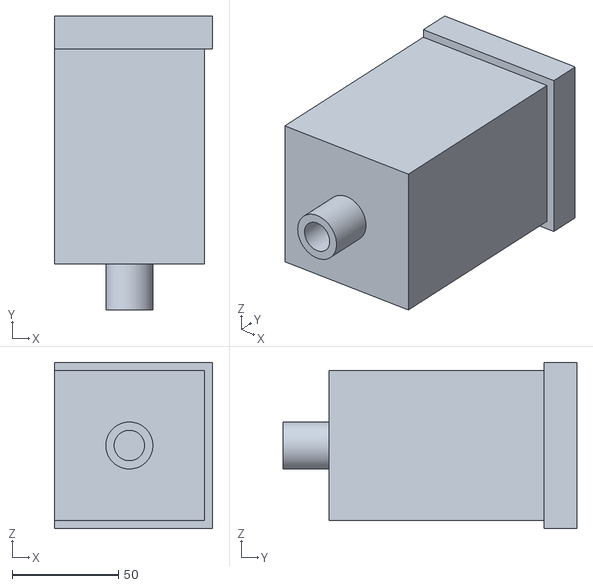
[picture p39: CAD file, 2021-03-25]
pipe_designs/3d_Print/053_closed_3.9mm.stl
74.3 x 138.1 x 78.2
