michaelkrzyzaniak/squiggles-pipe-organ/pipe_designs/3d_Print/070_closed_3.9mm.stl

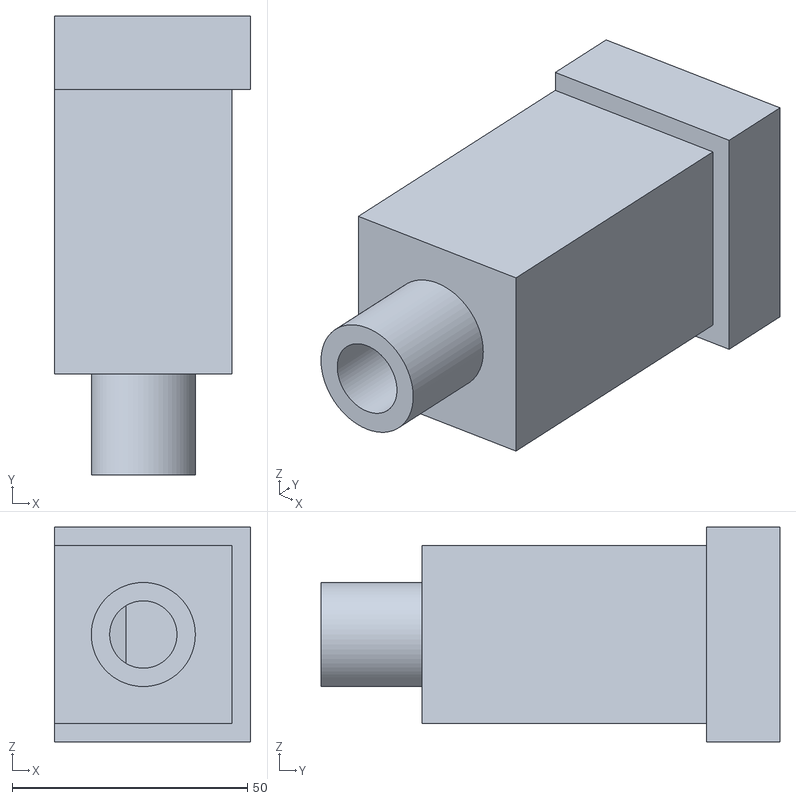
[picture p40: CAD file, 2021-03-25]
pipe_designs/3d_Print/070_closed_3.9mm.stl
41.7 x 97.5 x 45.6
