michaelkrzyzaniak/squiggles-pipe-organ/pipe_designs/3d_Print/067_closed_3.9mm.stl

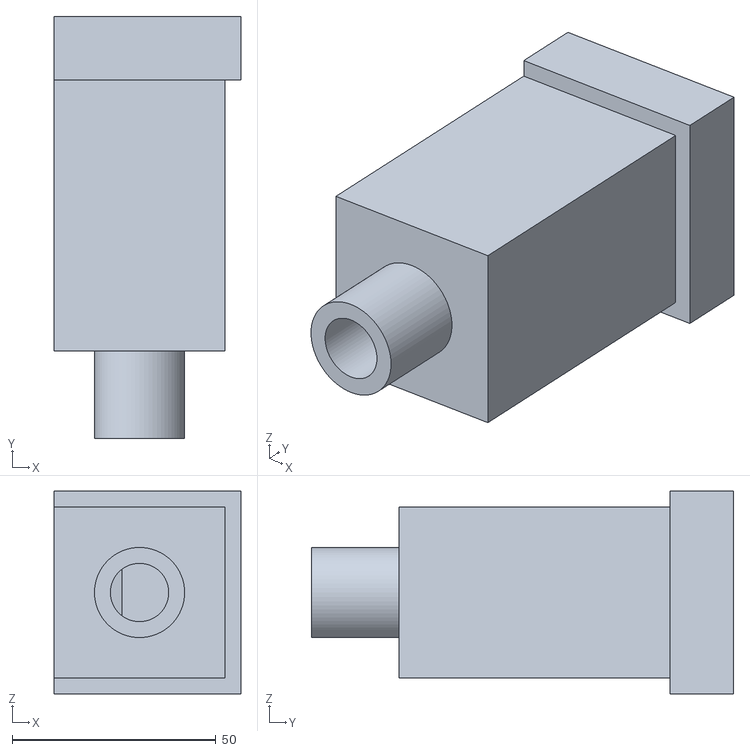
[picture p41: CAD file, 2021-03-25]
pipe_designs/3d_Print/067_closed_3.9mm.stl
45.8 x 103.5 x 49.7
