michaelkrzyzaniak/squiggles-pipe-organ/pipe_designs/3d_Print/062_closed_3.9mm.stl

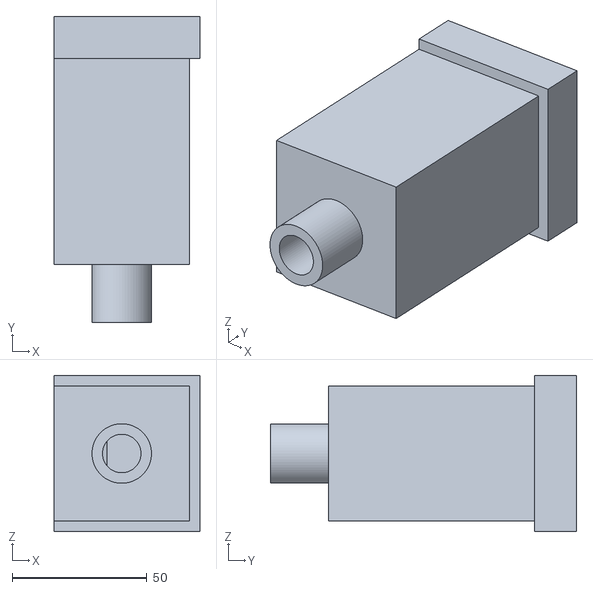
[picture p42: CAD file, 2021-03-25]
pipe_designs/3d_Print/062_closed_3.9mm.stl
54.1 x 113.7 x 58.0
