michaelkrzyzaniak/squiggles-pipe-organ/pipe_designs/3d_Print/068_closed_3.9mm.stl

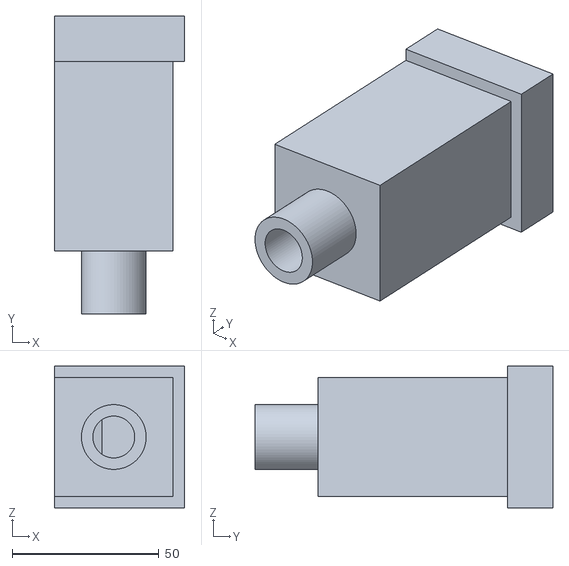
[picture p43: CAD file, 2021-03-25]
pipe_designs/3d_Print/068_closed_3.9mm.stl
44.4 x 101.7 x 48.3
