michaelkrzyzaniak/squiggles-pipe-organ/pipe_designs/3d_Print/075_closed_3.75mm.stl

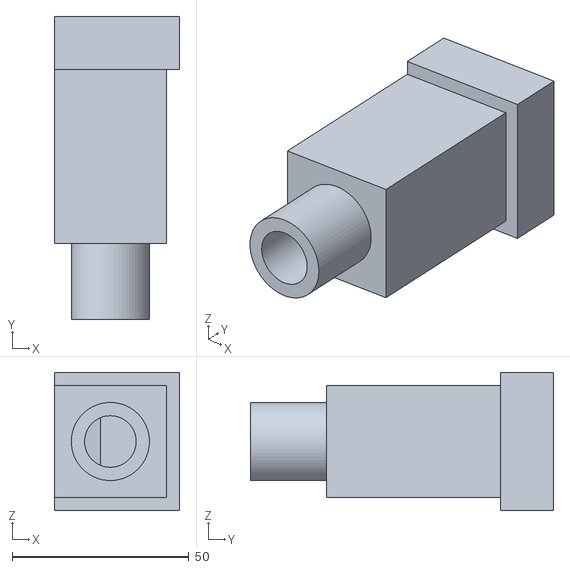
[picture p44: CAD file, 2020-12-22]
pipe_designs/3d_Print/075_closed_3.75mm.stl
35.4 x 85.8 x 39.1
