michaelkrzyzaniak/squiggles-pipe-organ/organ_pipe_maker/images/05_3d_print_done_alternate.jpg

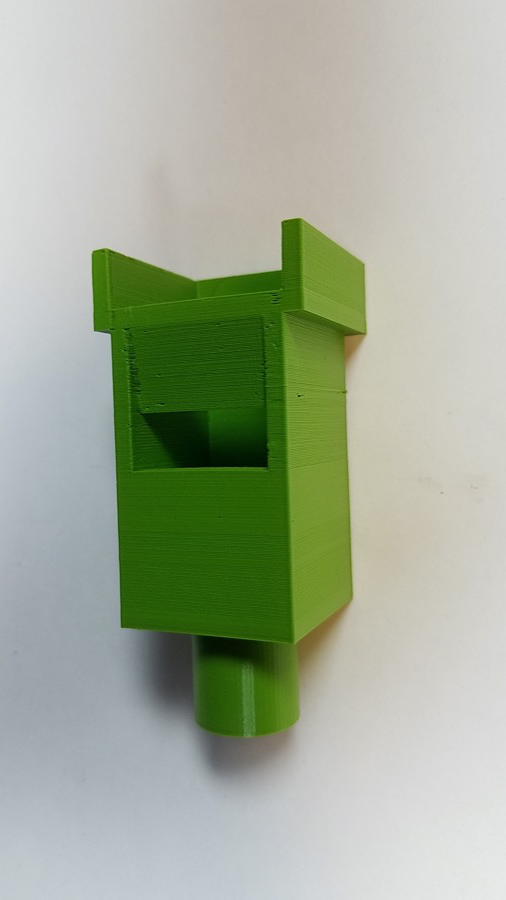
organ_pipe_maker/images/05_3d_print_done_alternate.jpg
