michaelkrzyzaniak/squiggles-pipe-organ/organ_pipe_maker/images/22_end_expoy_second_pipe.jpg

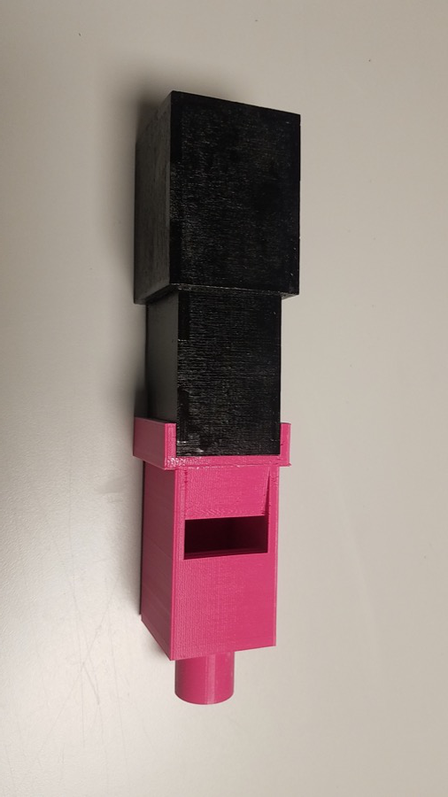
organ_pipe_maker/images/22_end_expoy_second_pipe.jpg
