michaelkrzyzaniak/squiggles-pipe-organ/pipe_designs/3d_Print_Settings.jpg

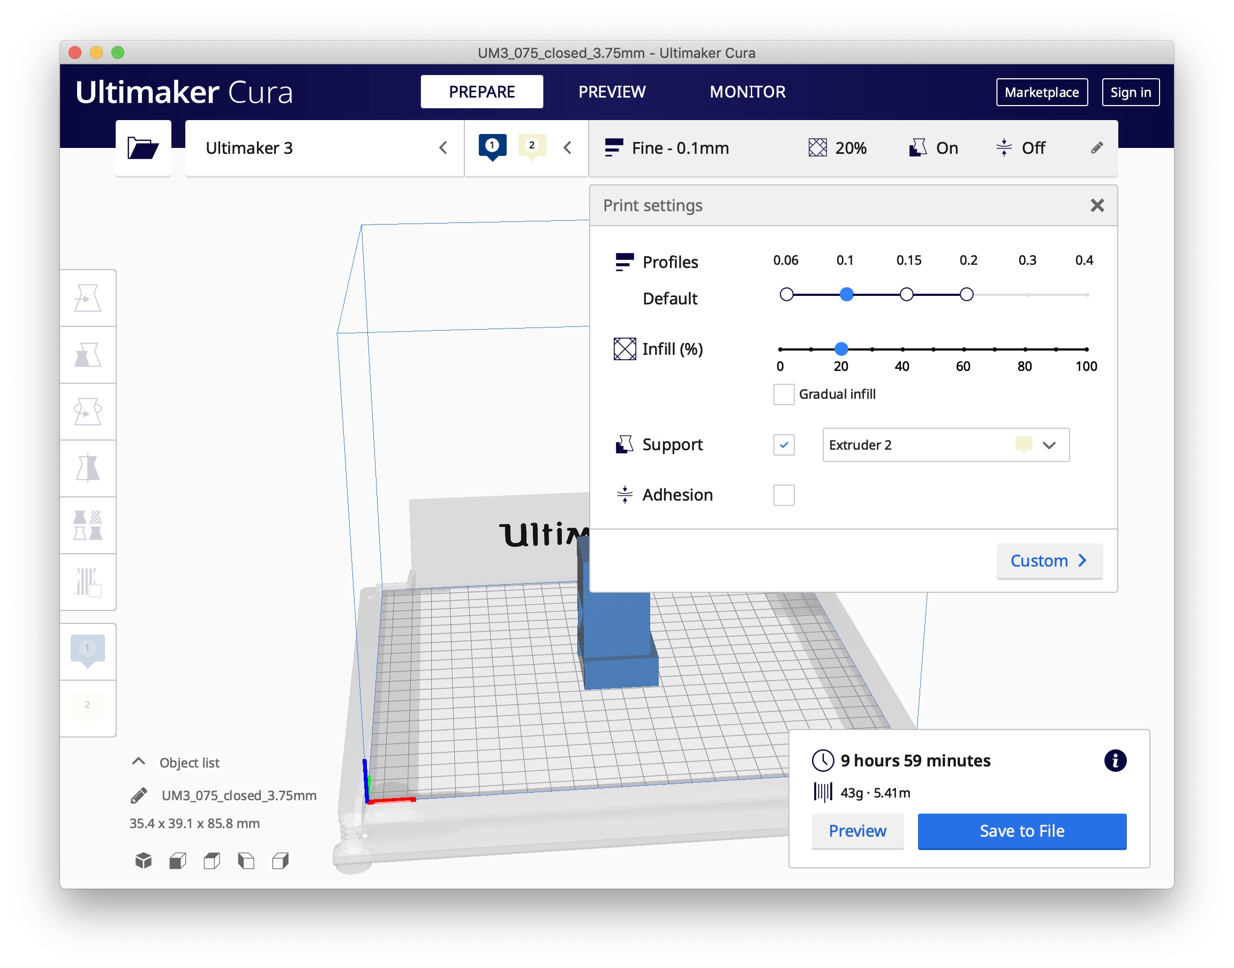
pipe_designs/3d_Print_Settings.jpg
