michaelkrzyzaniak/squiggles-pipe-organ/pipe_designs/Advanced_3d_Print_Settings.jpg

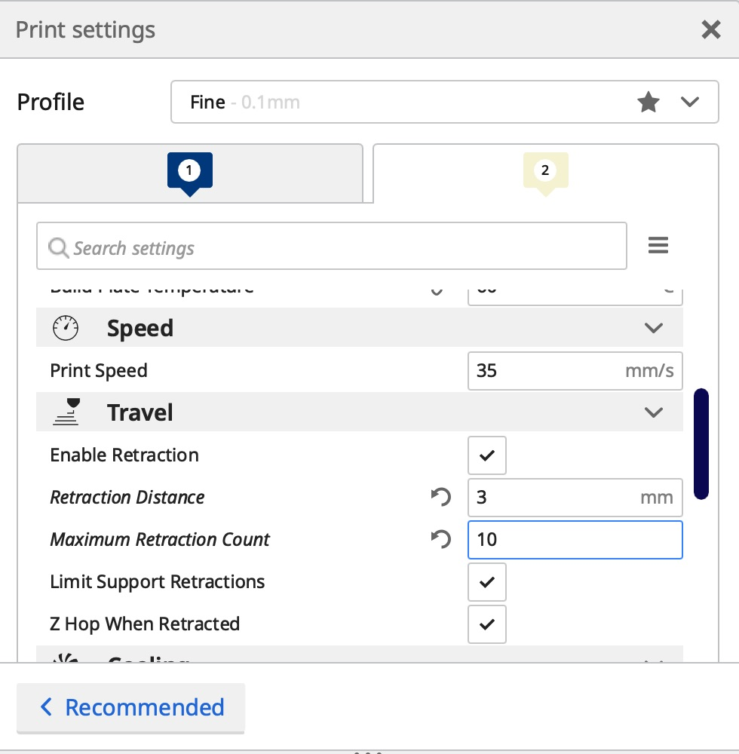
pipe_designs/Advanced_3d_Print_Settings.jpg
