michaelkrzyzaniak/squiggles-pipe-organ/wind_chest/design_files/drawing.pdf

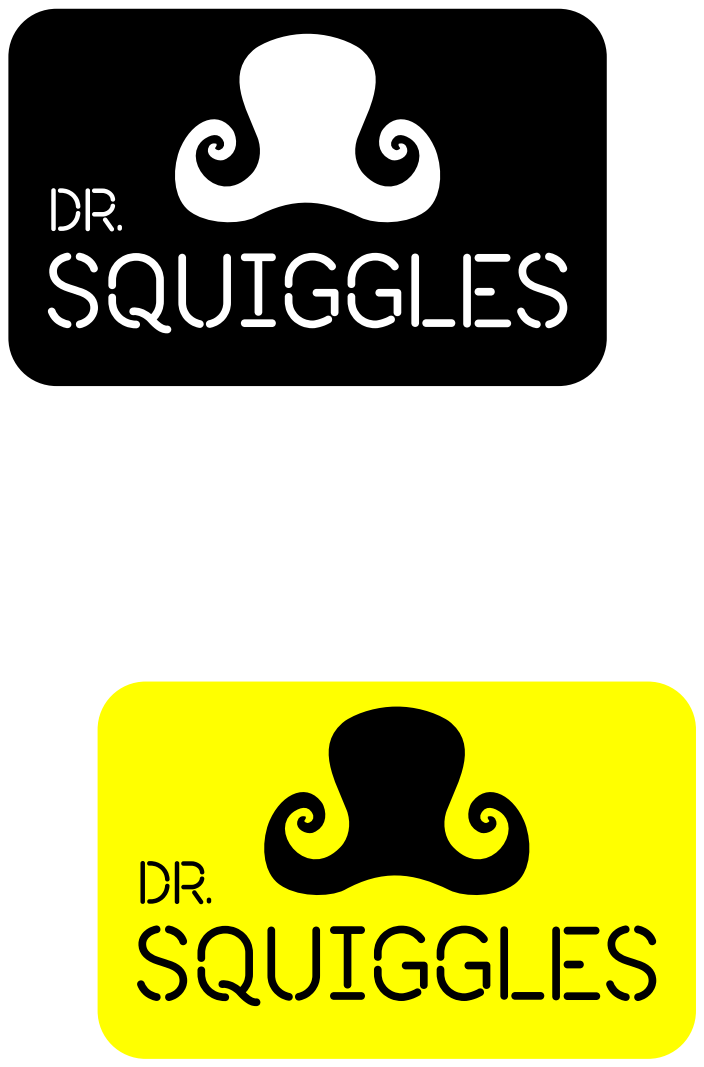
[picture p67: page 1]
Squiggles
