michaelkrzyzaniak/squiggles-pipe-organ/(commit log)

2020-12-22 First official organ pipe files
    [075_closed_3.75mm.stl]
2020-12-24 New organ pipe designs
    [070_closed_3.75mm.stl]
2021-03-23 C LSTM forward pass correct, validated against Python
    [DFT.c, DFT.h, fastsin.h, main.c]
2021-03-24 Kimo Sabe
    [052_closed_3.9mm.stl, 053_closed_3.9mm.stl, 054_closed_3.9mm.stl, 055_closed_3.9mm.stl, 056_closed_3.9mm.stl, 057_closed_3.9mm.stl, 058_closed_3.9mm.stl, 059_closed_3.9mm.stl]
2022-04-10 Dont Know
    [052_closed_3.9mm.stl, 053_closed_3.9mm.stl, 054_closed_3.9mm.stl, 055_closed_3.9mm.stl, 056_closed_3.9mm.stl, 057_closed_3.9mm.stl, 058_closed_3.9mm.stl, 059_closed_3.9mm.stl]
